roberts7531/JOX030/jox030.pdf

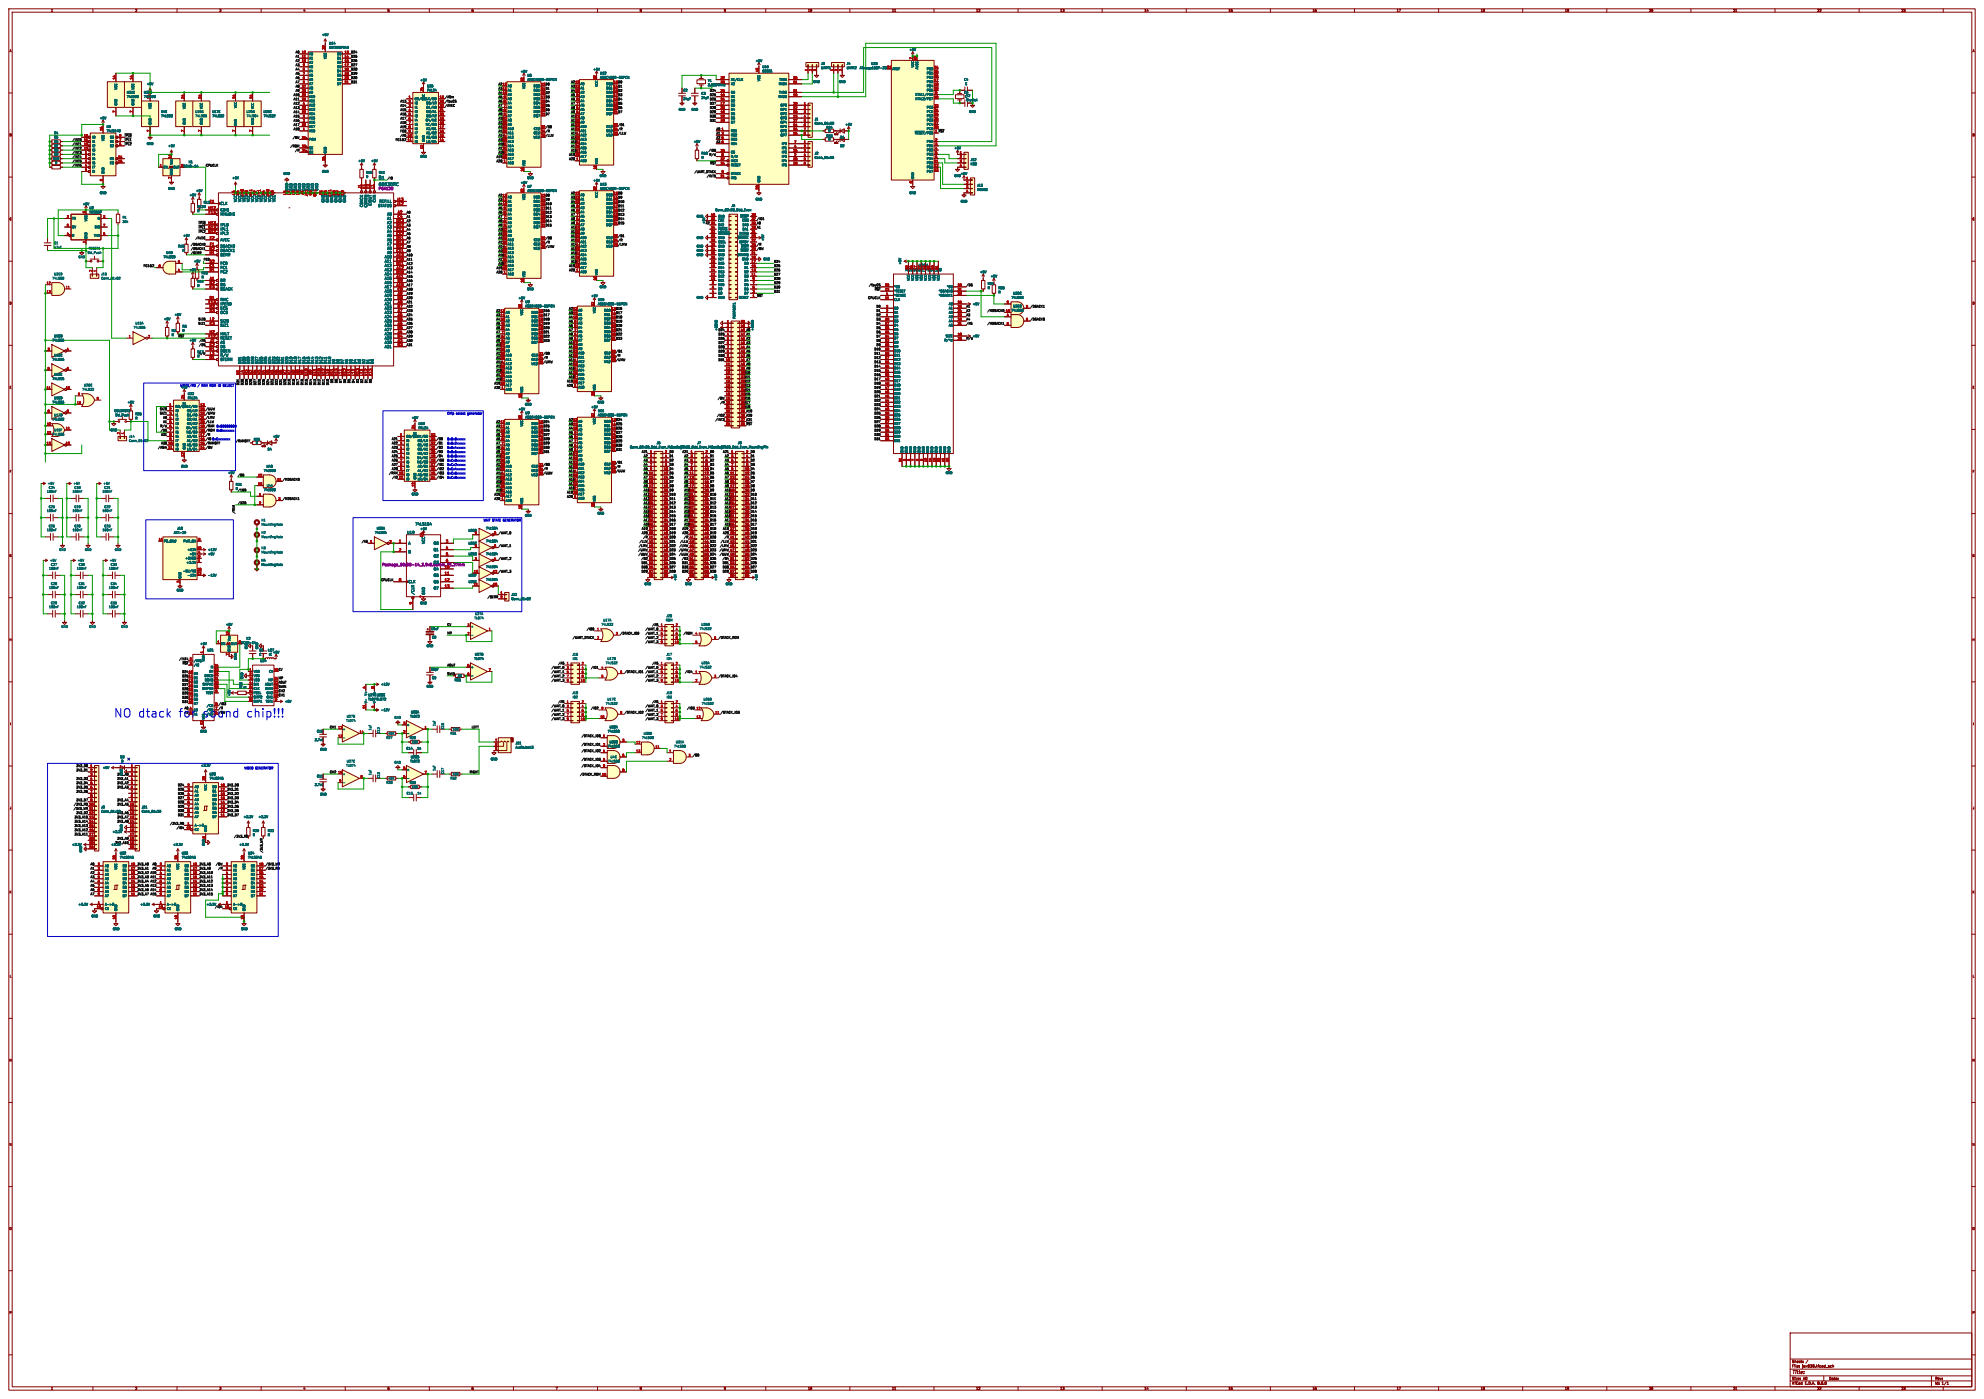
[picture p1: page 1]

0x0x2xxxxx NO dtack for sound chip!!!

Id: 1/1 Title: File: jox030.kicad_sch Sheet: /
