roberts7531/JOX030/ger/jox030-B_Cu.pdf

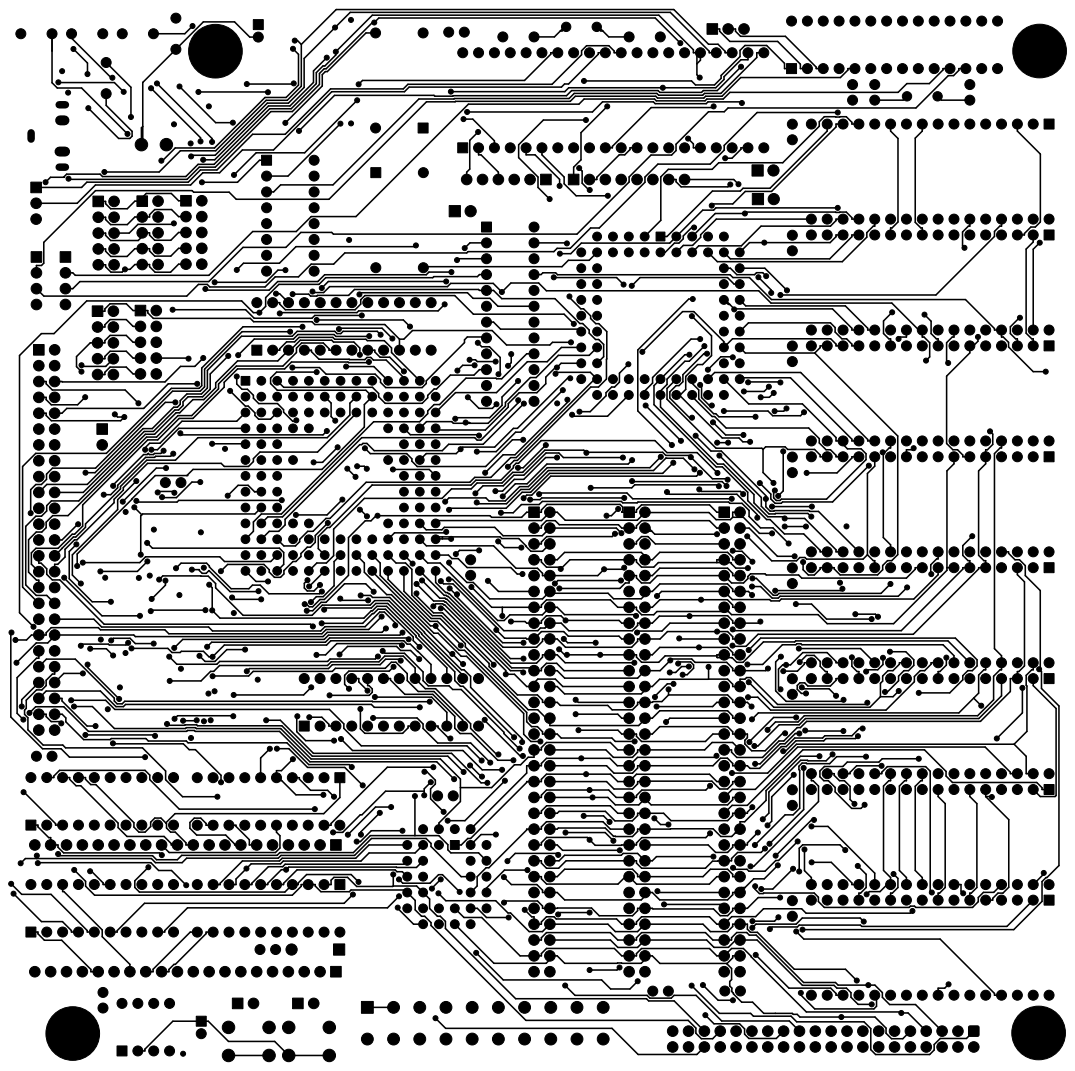
[picture p2: page 1]
