roberts7531/JOX030/ger/jox030-B_Mask.pdf

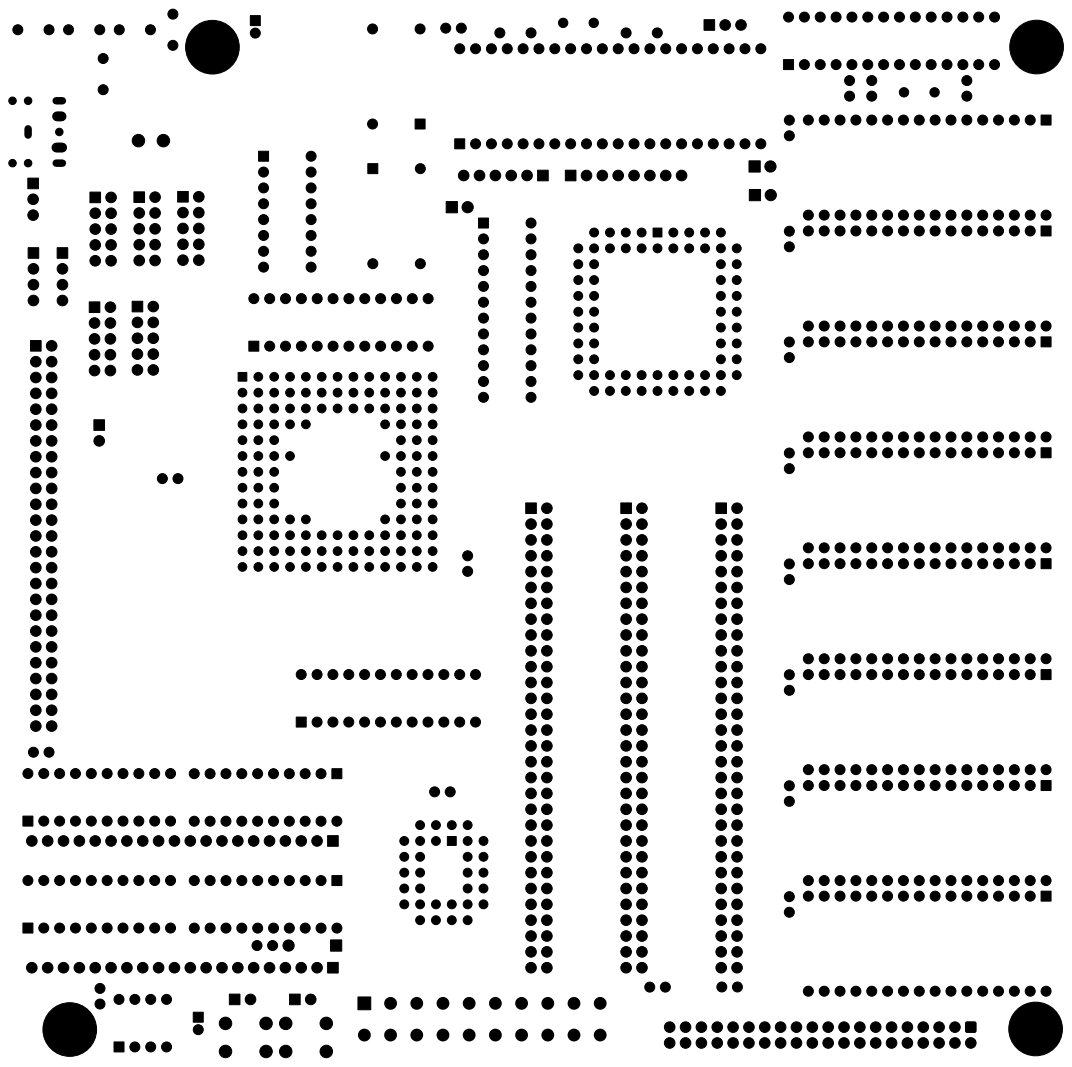
[picture p3: page 1]
