roberts7531/JOX030/ger/jox030-Edge_Cuts.pdf

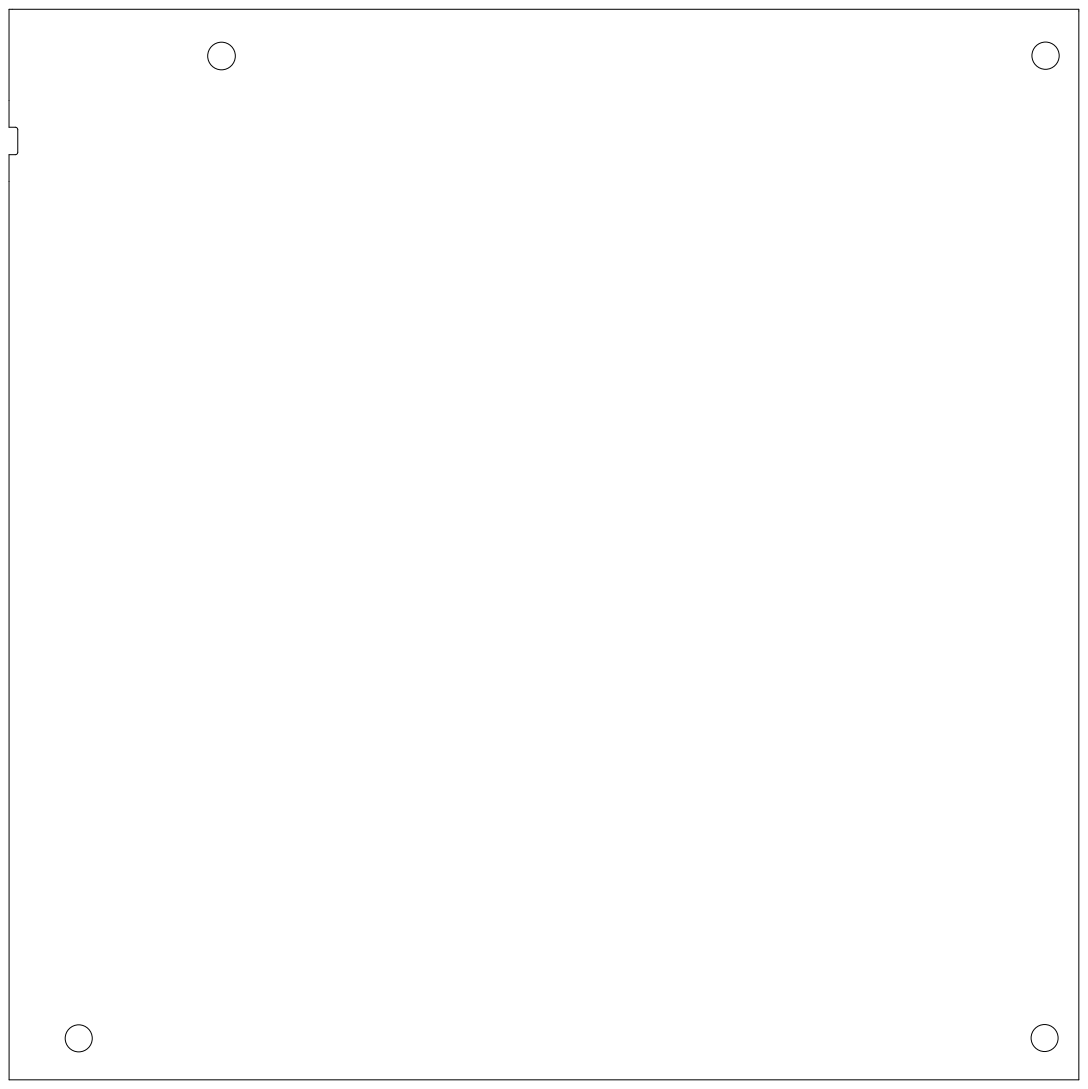
[picture p4: page 1]
