roberts7531/JOX030/ger/jox030-F_Cu.pdf

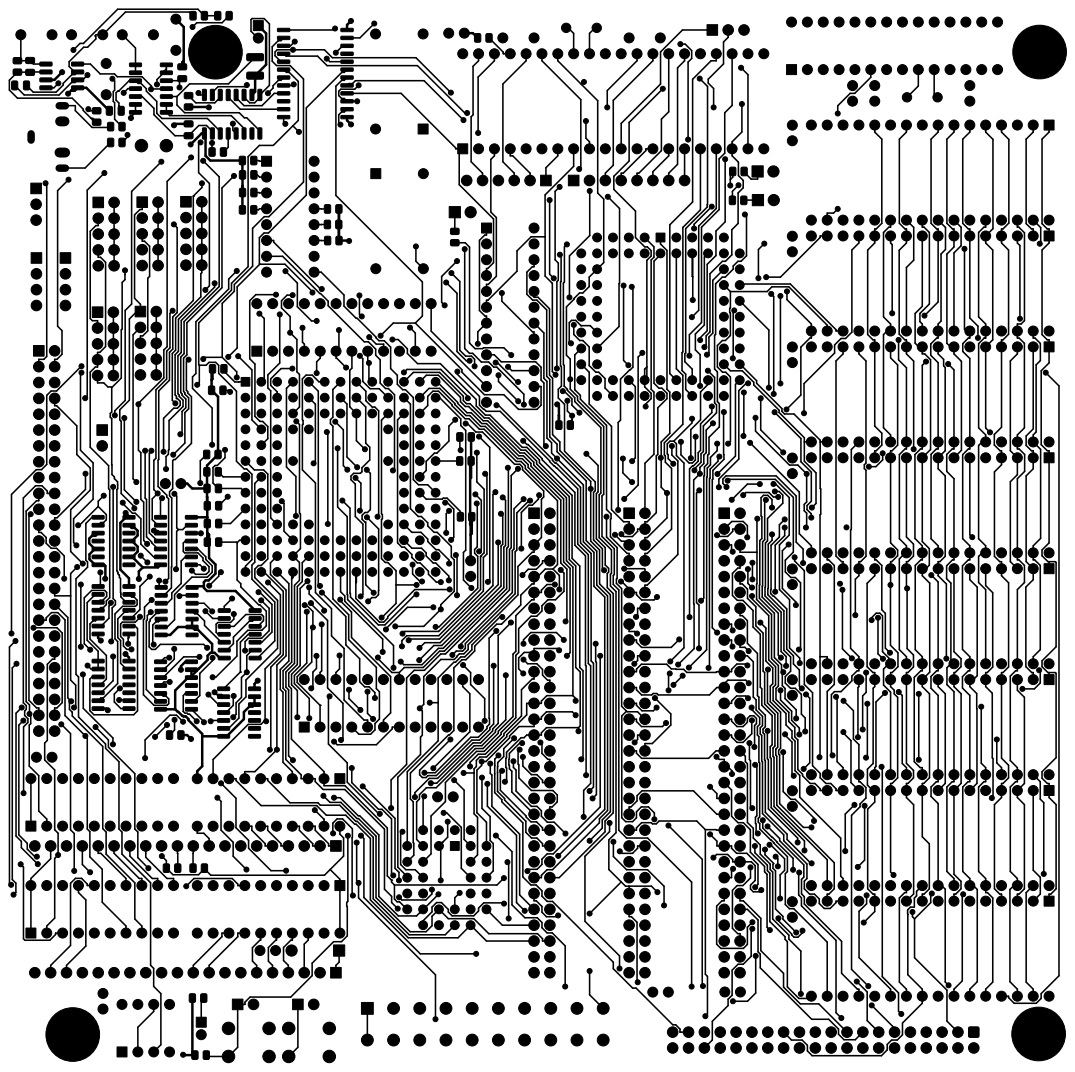
[picture p5: page 1]
