roberts7531/JOX030/ger/jox030-F_Mask.pdf

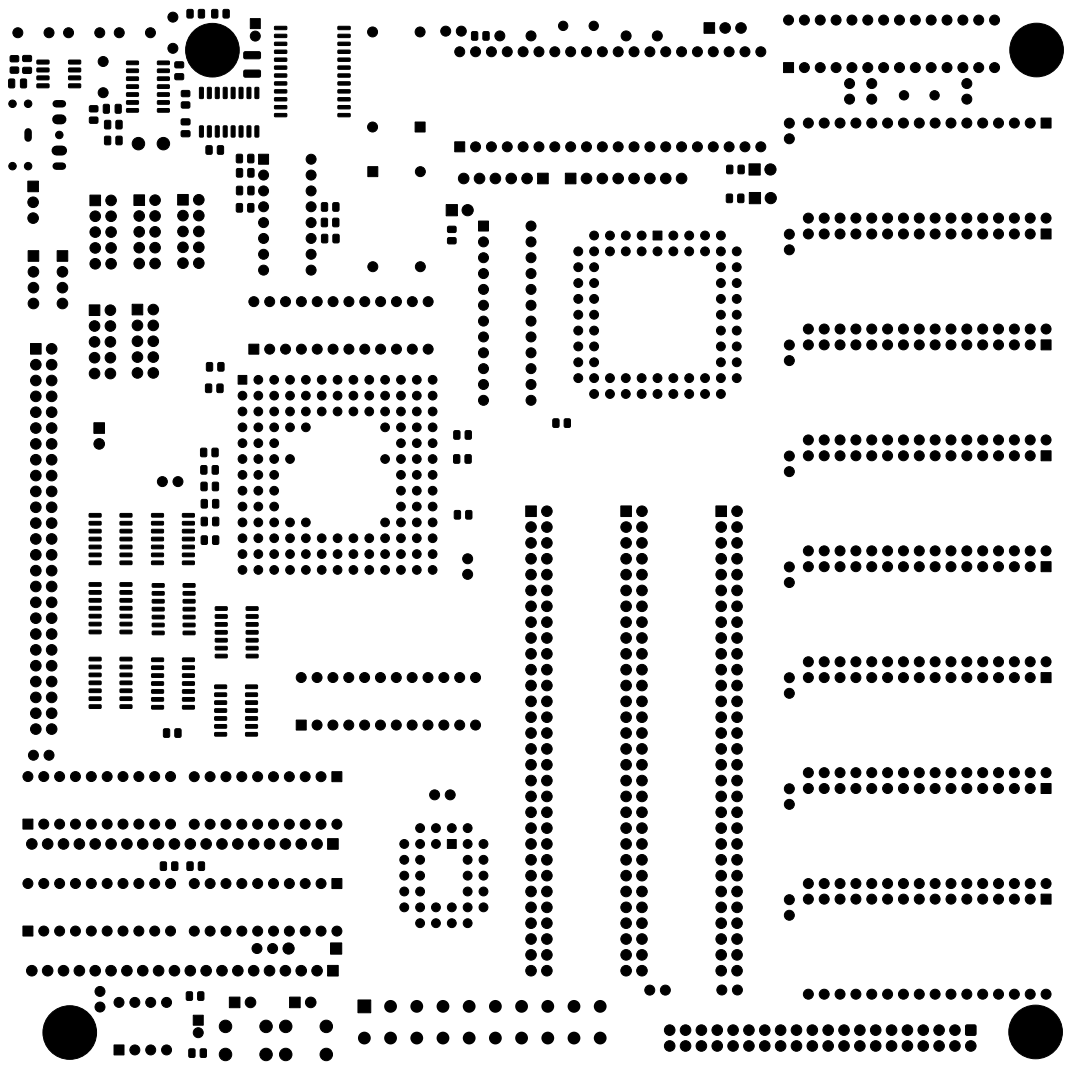
[picture p6: page 1]
