roberts7531/JOX030/ger/jox030-F_Paste.pdf

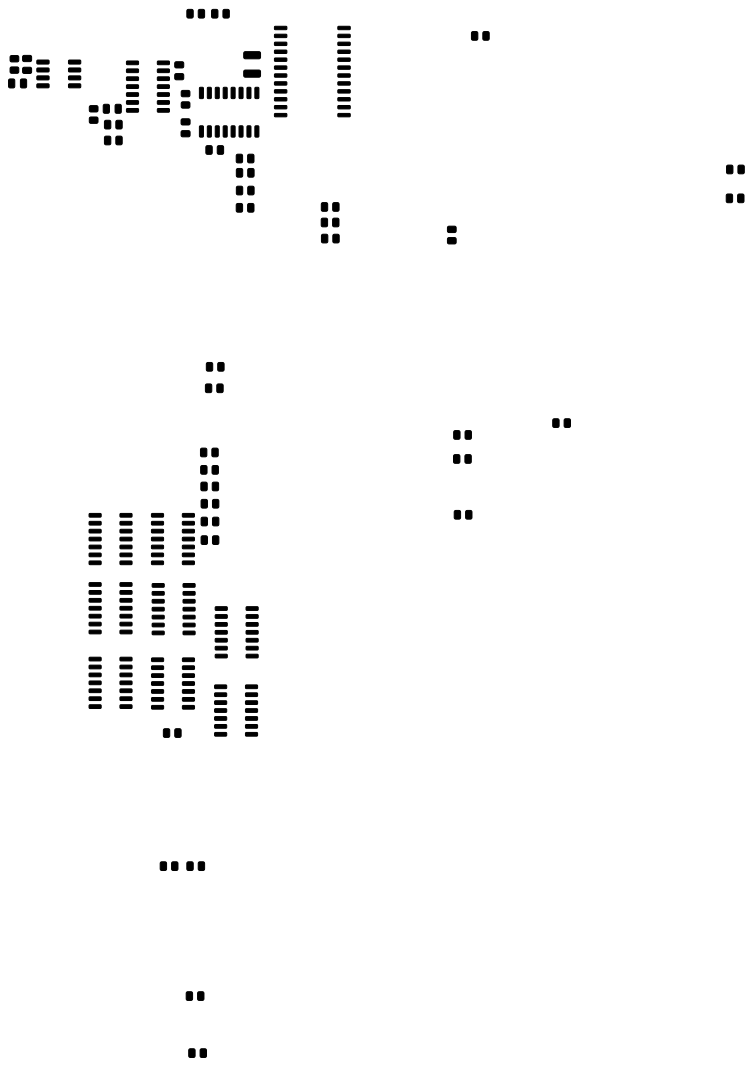
[picture p7: page 1]
