roberts7531/JOX030/ger/jox030-F_Silkscreen.pdf

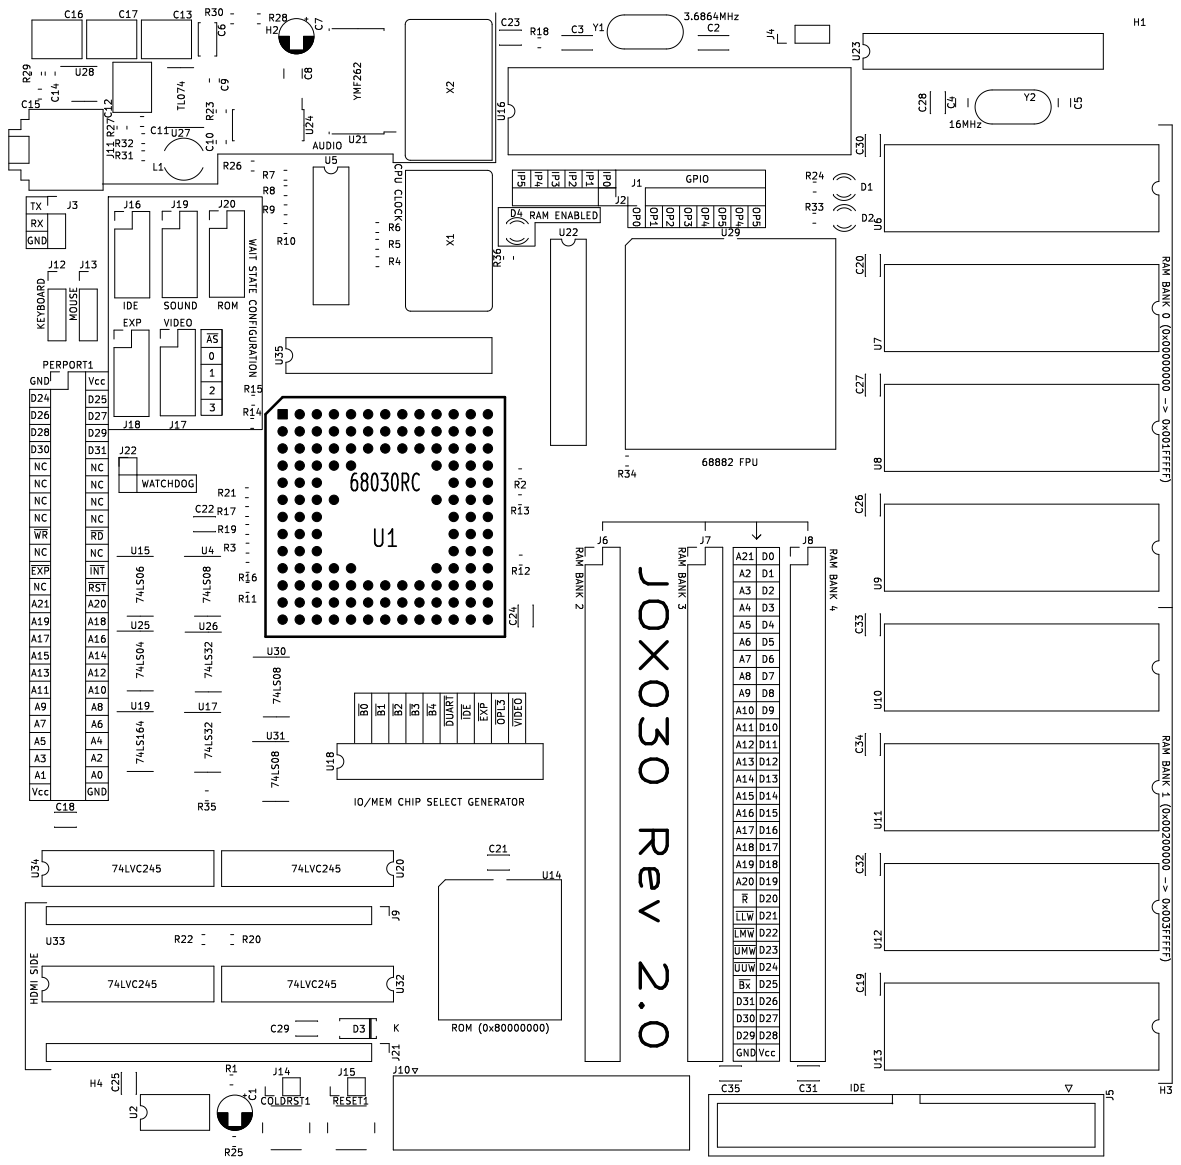
[picture p8: page 1]

IO/MEM CHIP SELECT GENERATOR
