roberts7531/JOX030/ger/jox030-In1_Cu.pdf

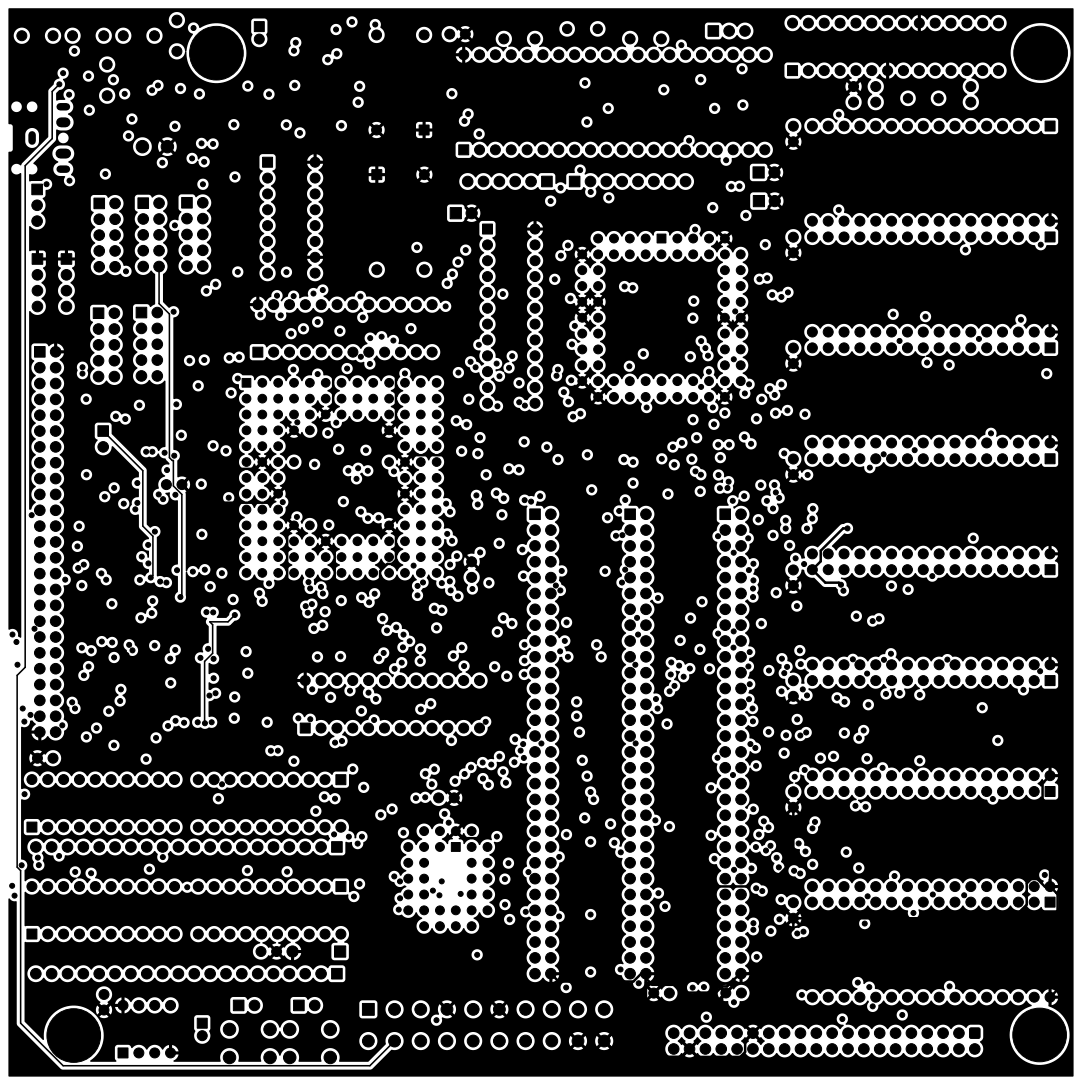
[picture p9: page 1]
