roberts7531/JOX030/ger/jox030-In2_Cu.pdf

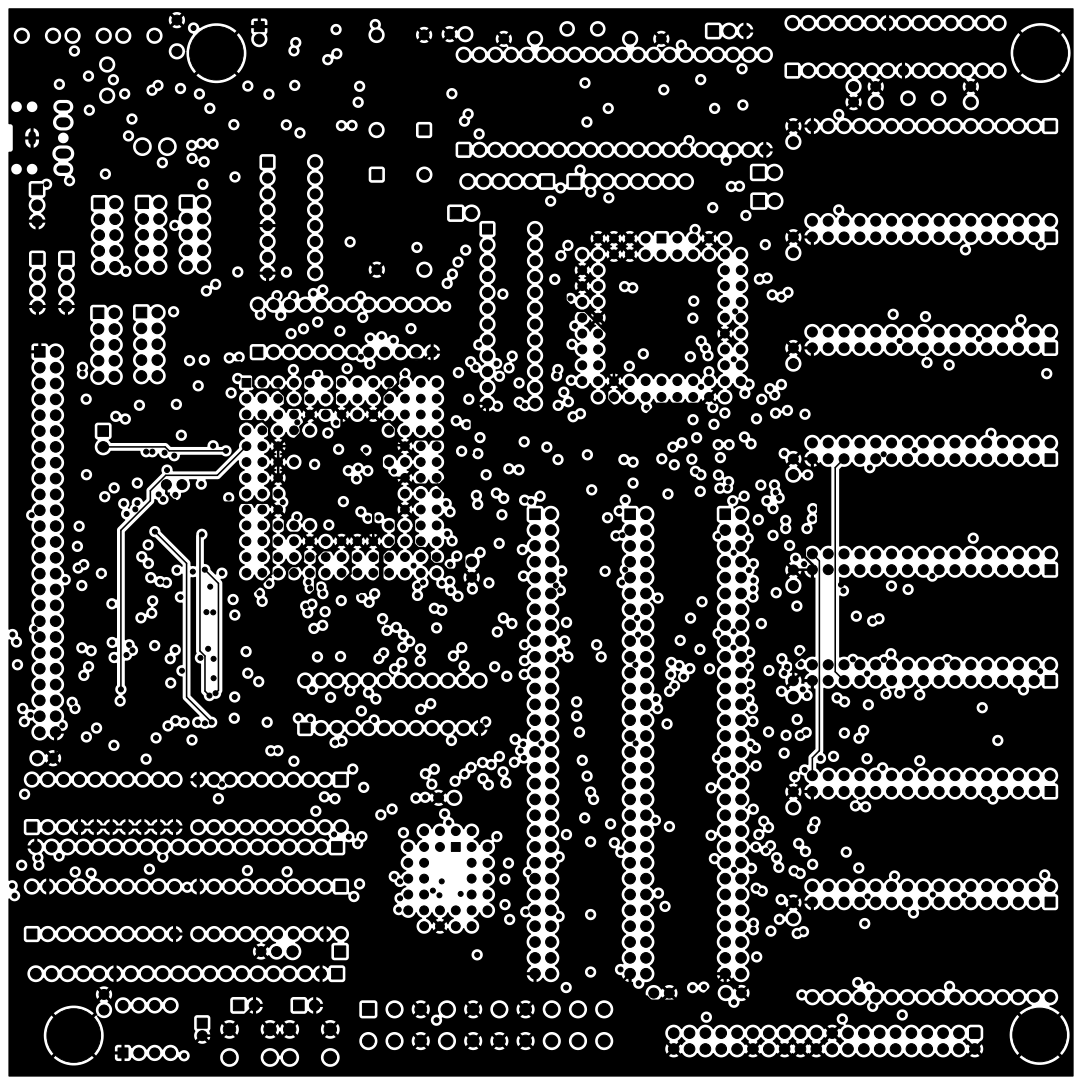
[picture p10: page 1]
