roberts7531/JOX030/(list of files, drawings)

Other design files:
freerouting.dsn
