roberts7531/JOX030/jox030.kicad_sch

## KiCad design jox030.kicad_sch (2024-05-07)

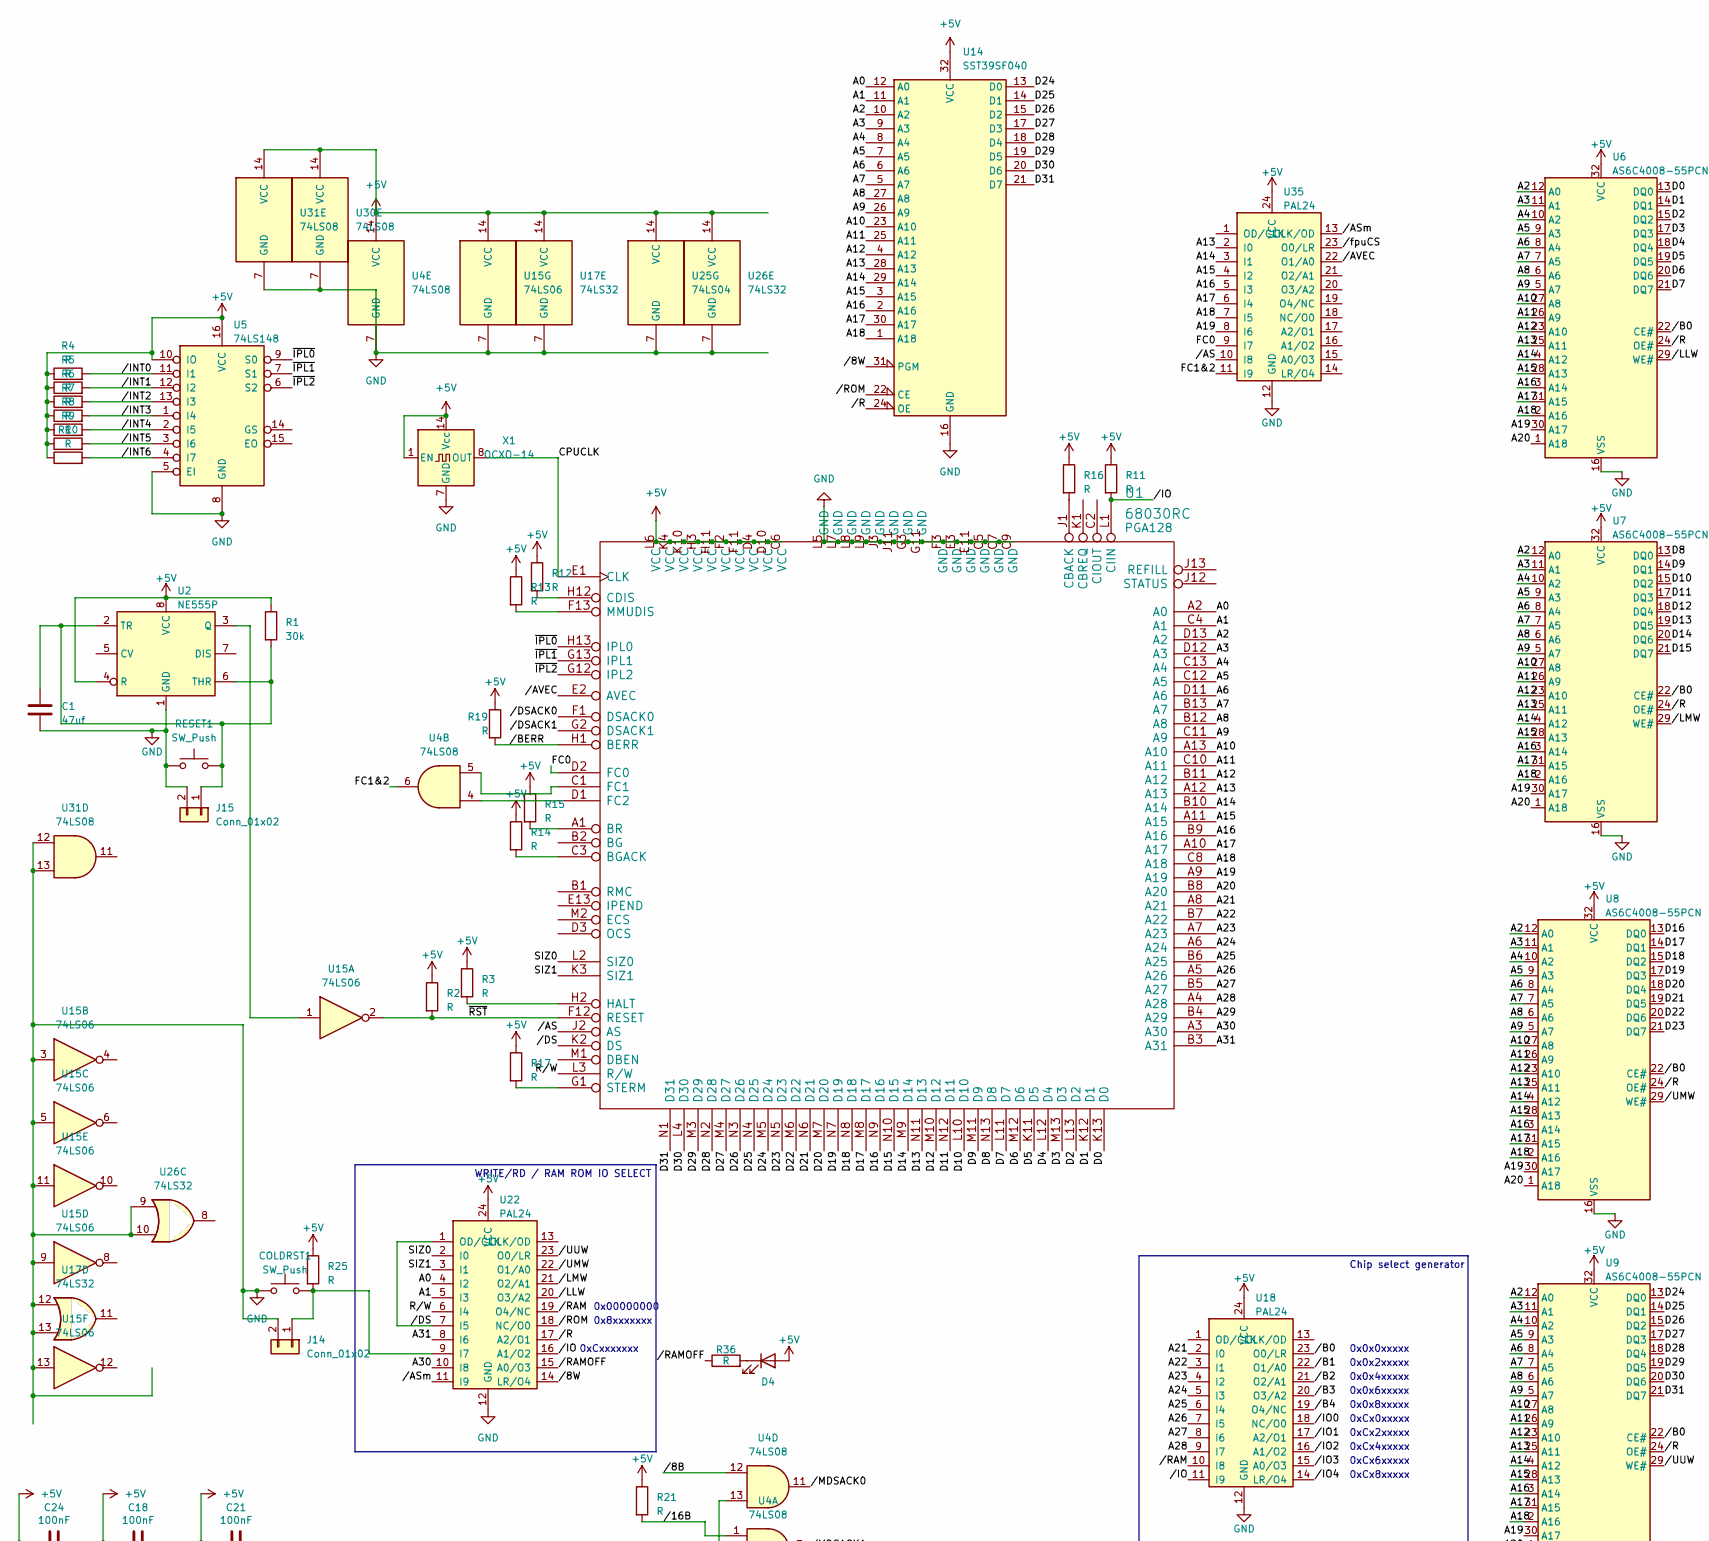
[picture p11: schematic jox030.kicad_sch, part in row 1, column 1]

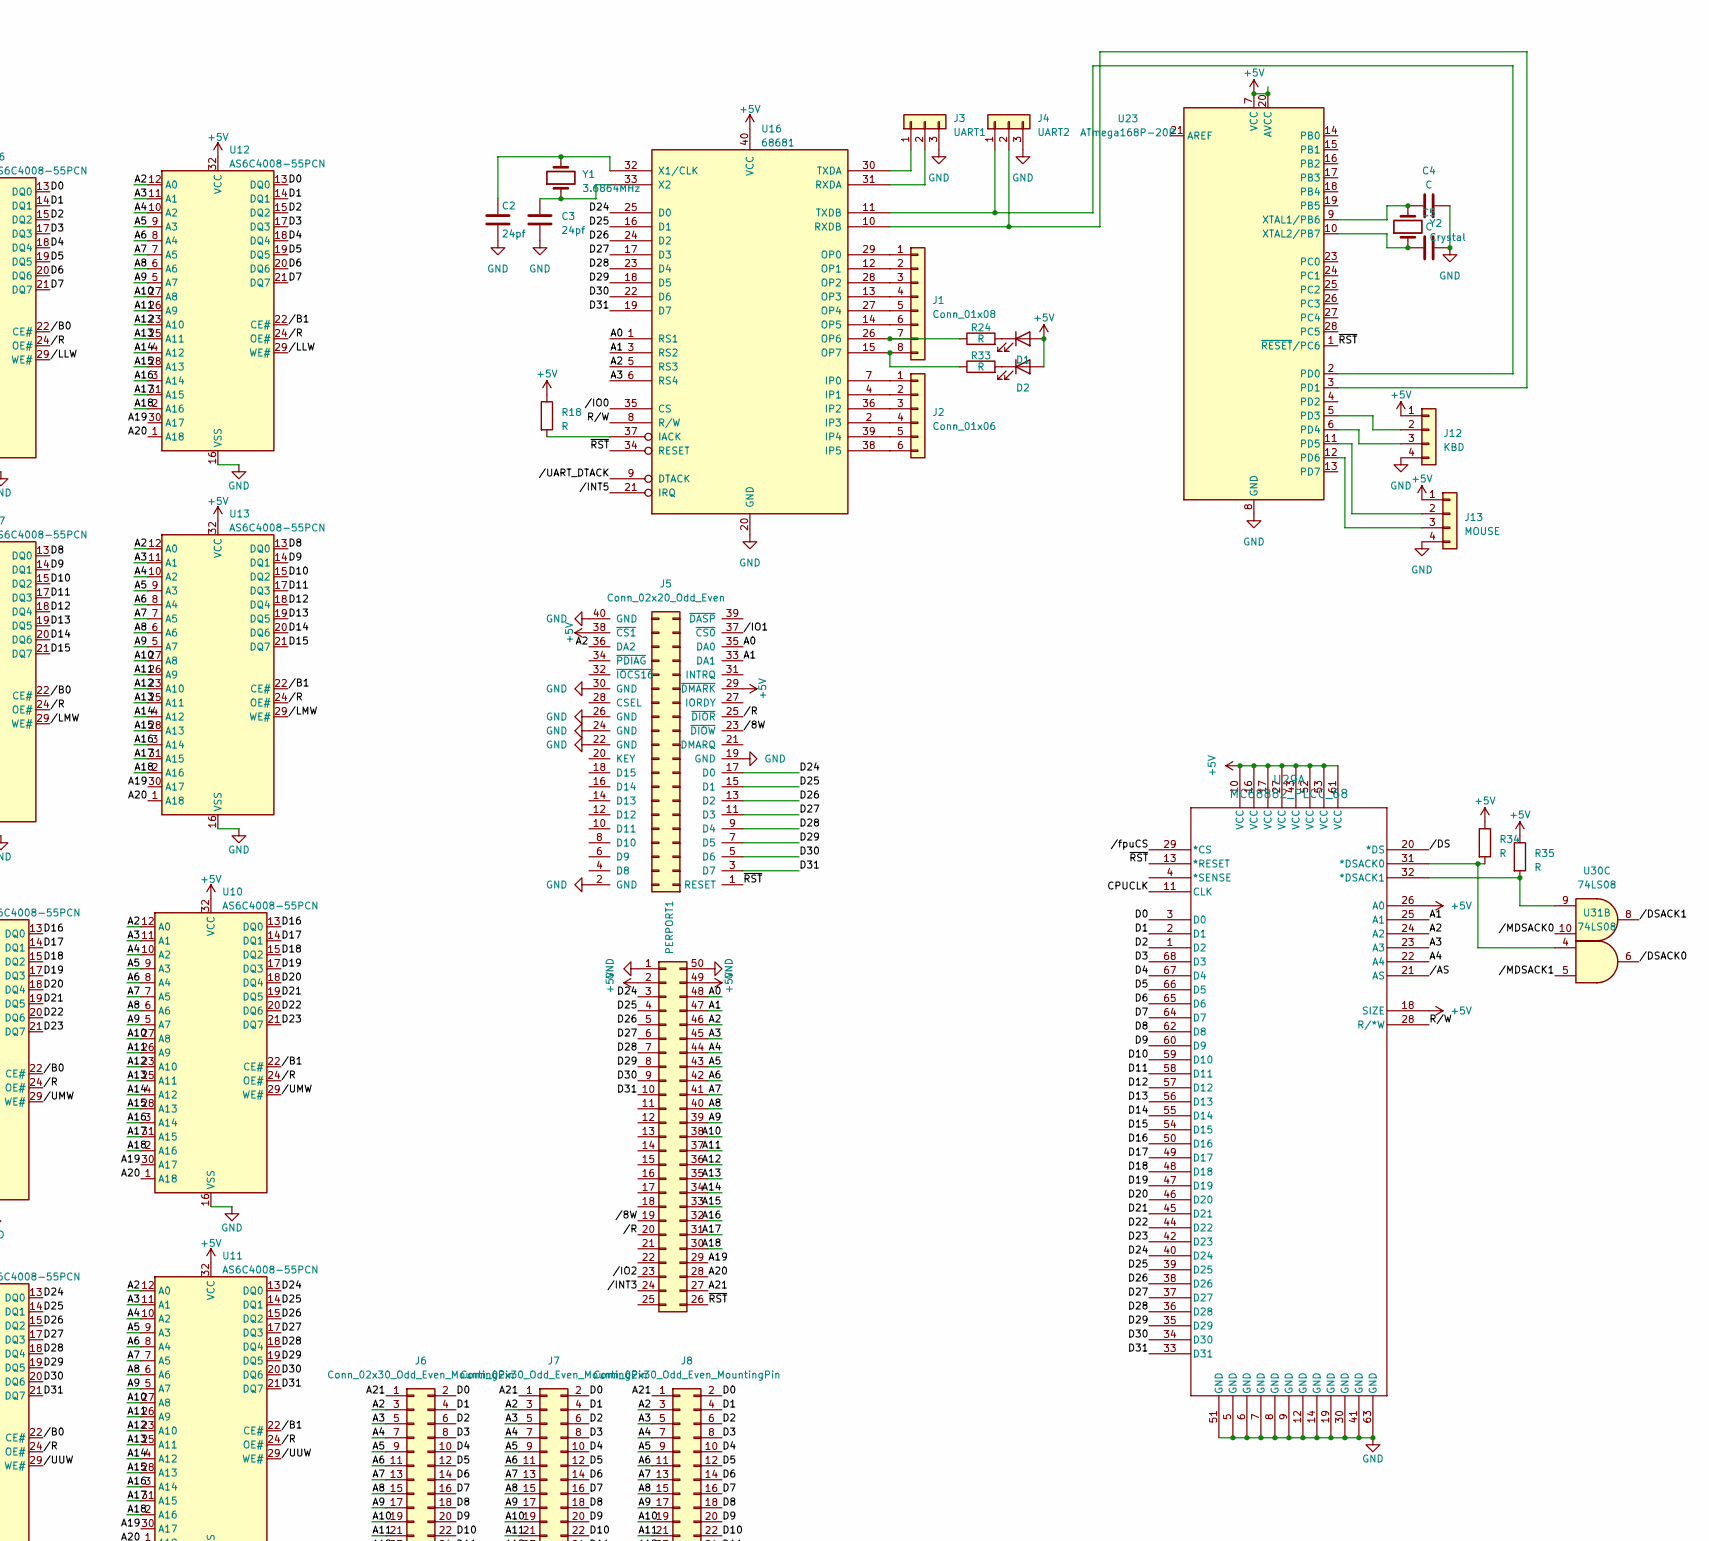
[picture p12: schematic jox030.kicad_sch, part in row 1, column 2]

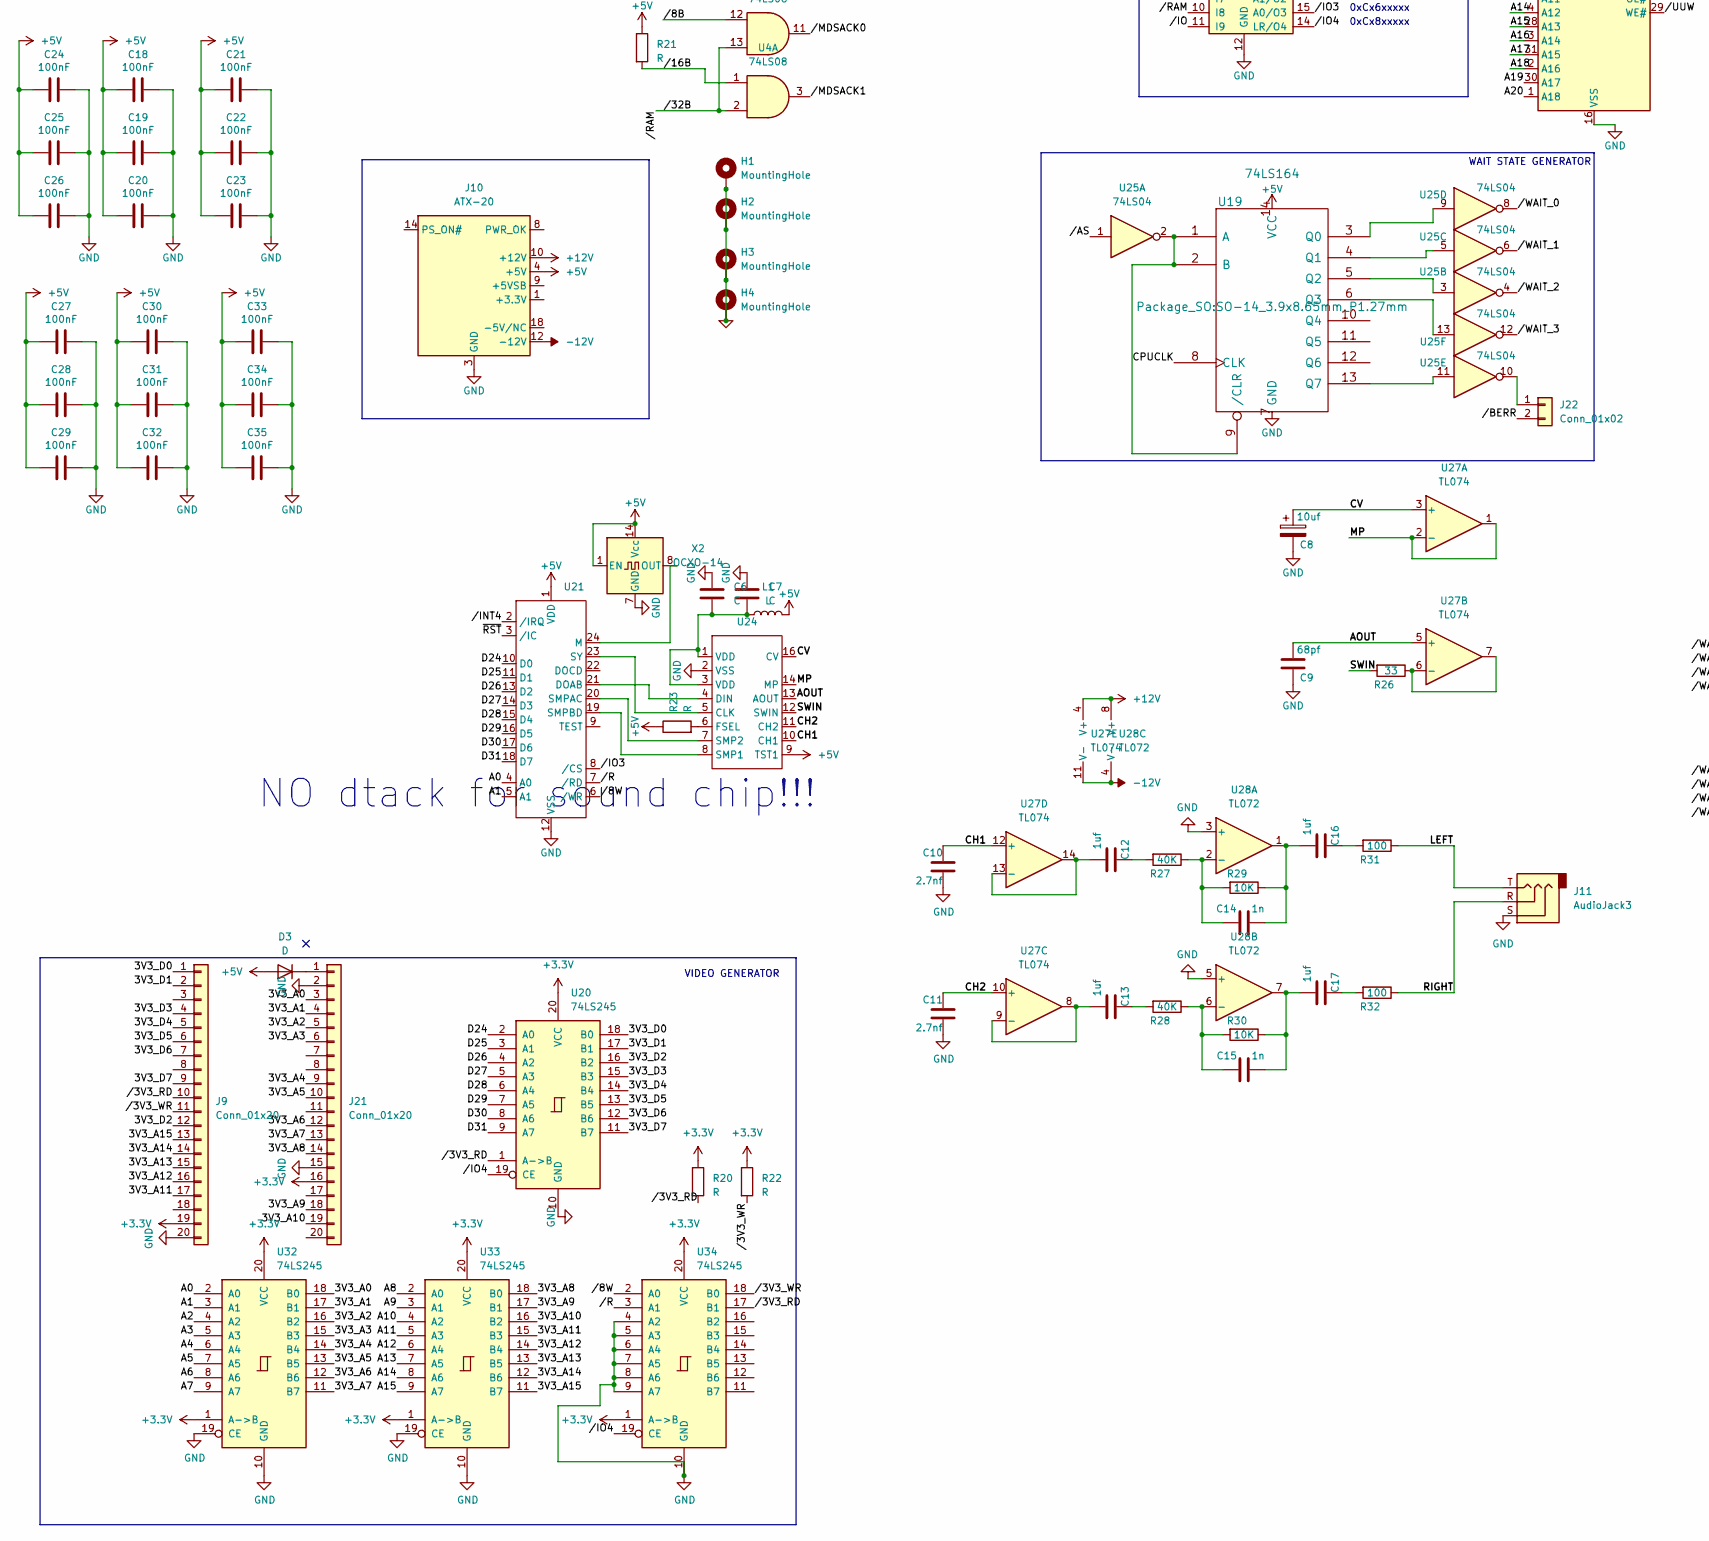
[picture p13: schematic jox030.kicad_sch, part in row 2, column 1]

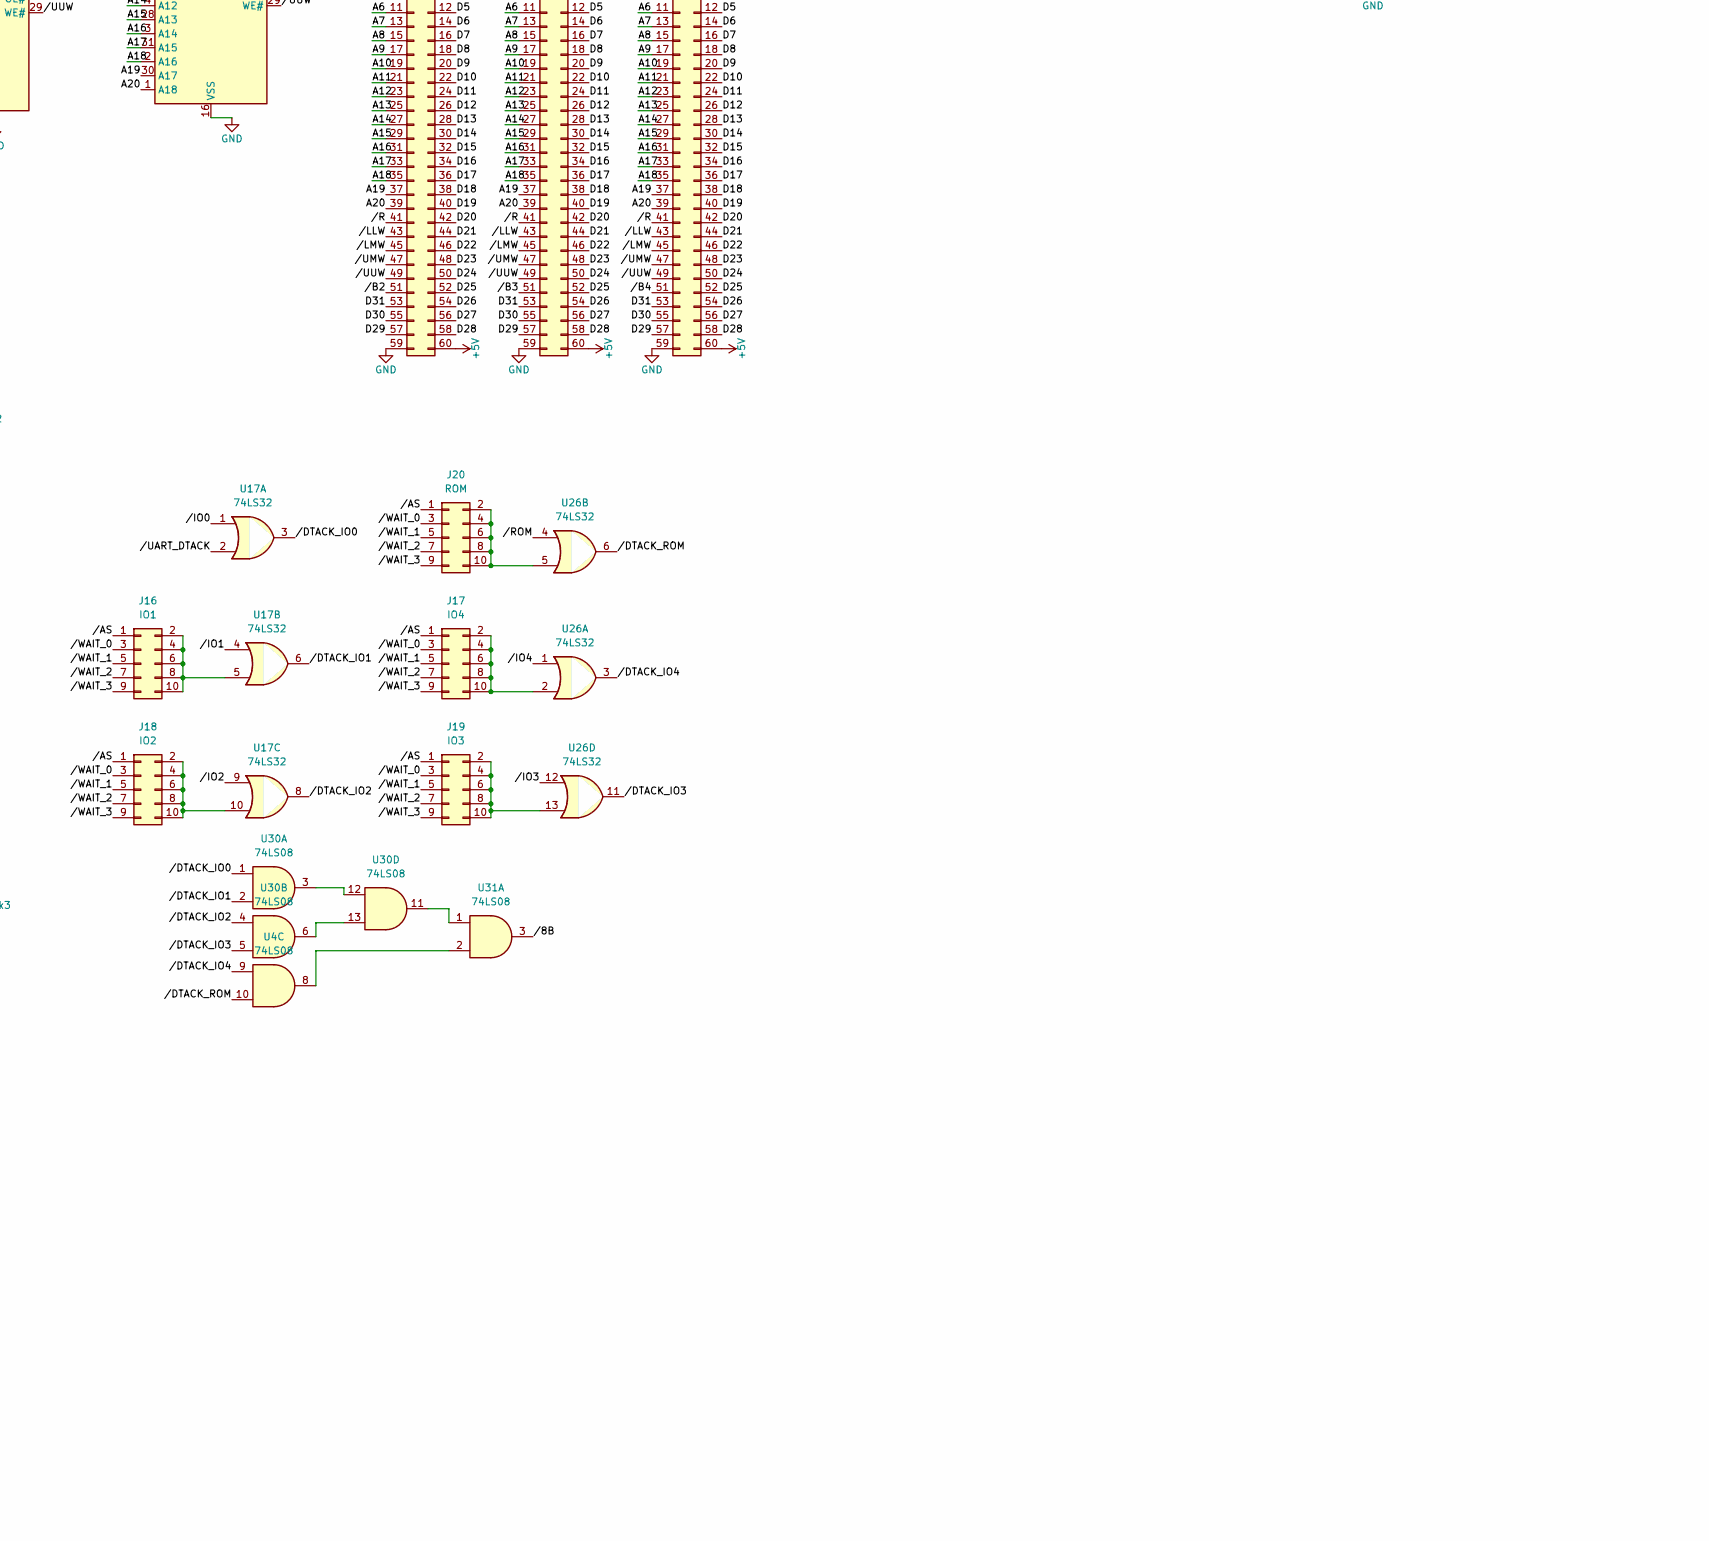
[picture p14: schematic jox030.kicad_sch, part in row 2, column 2]

Parts:
C1: 47uf; CP_Radial_D5.0mm_P2.00mm
C2, C3: 24pf; C_Disc_D4.3mm_W1.9mm_P5.00mm
C4, C5: C; C_Disc_D3.0mm_W1.6mm_P2.50mm
C6: C; C_Disc_D4.7mm_W2.5mm_P5.00mm
C7: C; CP_Radial_D5.0mm_P2.00mm
C8: 10uf; C_1210_3225Metric
C9: 68pf; C_0805_2012Metric
C10, C11: 2.7nf; C_0805_2012Metric
C12, C13, C16, C17: 1uf; C_Rect_L7.2mm_W5.5mm_P5.00mm_FKS2_FKP2_MKS2_MKP2
C14, C15: 1n; C_0805_2012Metric
C18, C19, C20, C21, C22, C23, C24, C25, C26, C27, C28, C29, C30, C31, C32, C33, C34, C35: 100nF; C_Disc_D3.0mm_W2.0mm_P2.50mm
COLDRST1: SW_Push; SW_PUSH_6mm
D1, D2, D4: FC2; LED_D3.0mm
D3: D; D_A-405_P7.62mm_Horizontal
H1, H2, H3, H4: MountingHole; MountingHole_4.3mm_M4_Pad_Via
J1: Conn_01x08; PinHeader_1x08_P2.54mm_Vertical
J2: Conn_01x06; PinHeader_1x06_P2.54mm_Vertical
J3: UART1; PinHeader_1x03_P2.54mm_Vertical
J4: UART2; PinHeader_1x03_P2.54mm_Vertical
J5: Conn_02x20_Odd_Even; IDC-Header_2x20_P2.54mm_Vertical
J6, J7, J8: Conn_02x30_Odd_Even_MountingPin; PinHeader_2x30_P2.54mm_Vertical
J9, J21: Conn_01x20; PinHeader_1x20_P2.54mm_Vertical
J10: ATX-20; MOLEX_39281203
J11: AudioJack3; Jack_3.5mm_CUI_SJ1-3525N_Horizontal
J12: KBD; PinHeader_1x04_P2.54mm_Vertical
J13: MOUSE; PinHeader_1x04_P2.54mm_Vertical
J14, J15, J22: Conn_01x02; PinHeader_1x02_P2.54mm_Vertical
J16: IO1; PinHeader_2x05_P2.54mm_Vertical
J17: IO4; PinHeader_2x05_P2.54mm_Vertical
J18: IO2; PinHeader_2x05_P2.54mm_Vertical
J19: IO3; PinHeader_2x05_P2.54mm_Vertical
J20: ROM; PinHeader_2x05_P2.54mm_Vertical
L1: L; L_Radial_D6.0mm_P4.00mm
PERPORT1: Conn_02x20_Counter_Clockwise; PinHeader_2x25_P2.54mm_Vertical
R1: 30k; R_0805_2012Metric
R2, R3, R4, R5, R6, R7, R8, R9, R10, R11, R12, R13, R14, R15, R16, R17, R18, R19, R20, R21, R22, R23, R24, R25, R33, R34, R35, R36: R; R_0805_2012Metric
R26: 33; R_0805_2012Metric
R27, R28: 40K; R_0805_2012Metric
R29, R30: 10K; R_0805_2012Metric
R31, R32: 100; R_0805_2012Metric
RESET1: SW_Push; SW_PUSH_6mm
U1: 68030RC; PGA128
U2: NE555P; DIP-8_W7.62mm
U4, U30, U31: 74LS08; SO-14_3.9x8.65mm_P1.27mm
U5: 74LS148; DIP-16_W7.62mm
U6, U7, U8, U9, U10, U11, U12, U13: AS6C4008-55PCN; DIP-32_W15.24mm
U14: SST39SF040; PLCC-32_THT-Socket
U15: 74LS06; SO-14_3.9x8.65mm_P1.27mm
U16: 68681; DIP-40_W15.24mm
U17, U26: 74LS32; SO-14_3.9x8.65mm_P1.27mm
U18, U22, U35: PAL24; DIP-24_W7.62mm
U19: 74LS164; SO-14_3.9x8.65mm_P1.27mm
U20, U32, U33, U34: 74LS245; DIP-20_W7.62mm
U21: SOP-24_7.5x15.4mm_P1.27mm
U23: ATmega168P-20P; DIP-28_W7.62mm
U24: SOP-16_4.4x10.4mm_P1.27mm
U25: 74LS04; SO-14_3.9x8.65mm_P1.27mm
U27: TL074; SO-14_3.9x8.65mm_P1.27mm
U28: TL072; SOP-8_3.76x4.96mm_P1.27mm
U29: MC68882_PLCC_68; PLCC-68_THT-Socket
X1, X2: OCXO-14; Oscillator_DIP-14
Y1: 3.6864MHz; Crystal_HC18-U_Vertical
Y2: Crystal; Crystal_HC18-U_Vertical

Connections:
3V3_A0: J21.3, U32.18 (B0)
3V3_A1: J21.4, U32.17 (B1)
3V3_A2: J21.5, U32.16 (B2)
3V3_A3: J21.6, U32.15 (B3)
3V3_A4: J21.9, U32.14 (B4)
3V3_A5: J21.10, U32.13 (B5)
3V3_A6: J21.12, U32.12 (B6)
3V3_A7: J21.13, U32.11 (B7)
3V3_A8: J21.14, U33.18 (B0)
3V3_A9: J21.18, U33.17 (B1)
3V3_A10: J21.19, U33.16 (B2)
3V3_A11: J9.17, U33.15 (B3)
3V3_A12: J9.16, U33.14 (B4)
3V3_A13: J9.15, U33.13 (B5)
3V3_A14: J9.14, U33.12 (B6)
3V3_A15: J9.13, U33.11 (B7)
3V3_D0: J9.1, U20.18 (B0)
3V3_D1: J9.2, U20.17 (B1)
3V3_D2: J9.12, U20.16 (B2)
3V3_D3: J9.4, U20.15 (B3)
3V3_D4: J9.5, U20.14 (B4)
3V3_D5: J9.6, U20.13 (B5)
3V3_D6: J9.7, U20.12 (B6)
3V3_D7: J9.9, U20.11 (B7)
+3.3V: J9.19, J21.16, R20.1, R22.1, U20.20 (VCC), U32.1 (A->B), U32.20 (VCC), U33.1 (A->B), U33.20 (VCC), U34.1 (A->B), U34.20 (VCC)
+5V: C18.2, C19.2, C20.2, C21.2, C22.2, C23.2, C24.2, C25.2, C26.2, C27.2, C28.2, C29.2, C30.2, C31.2, C32.2, C33.2, C34.2, C35.2, D1.2 (A), D2.2 (A), D3.2 (A), D4.2 (A), J5.29 (~DMARK), J5.38 (~CS1), J6.60, J7.60, J8.60, J10.4 (+5V), J10.6 (+5V), J10.19 (+5V), J10.20 (+5V), J12.1, J13.1, L1.2, PERPORT1.2, PERPORT1.49, R1.1, R2.1, R3.1, R4.1, R5.1, R6.1, R7.1, R8.1, R9.1, R10.1, R11.1, R12.1, R13.1, R14.1, R15.1, R16.1, R17.1, R18.1, R19.1, R21.1, R23.1, R25.1, R34.1, R35.1, U1.C6 (VCC), U1.D4 (VCC), U1.D10 (VCC), U1.F2 (VCC), U1.F11 (VCC), U1.H3 (VCC), U1.H11 (VCC), U1.K4 (VCC), U1.K10 (VCC), U1.L6 (VCC), U2.4 (R), U2.8 (VCC), U4.14 (VCC), U5.10 (IO), U5.16 (VCC), U6.32 (VCC), U7.32 (VCC), U8.32 (VCC), U9.32 (VCC), U10.32 (VCC), U11.32 (VCC), U12.32 (VCC), U13.32 (VCC), U14.32 (VCC), U15.14 (VCC), U16.40 (VCC), U17.14 (VCC), U18.24 (VCC), U19.14 (VCC), U21.1 (VDD), U22.24 (VCC), U23.7 (VCC), U23.20 (AVCC), U24.9 (TST1), U25.14 (VCC), U26.14 (VCC), U29.10 (VCC), U29.16 (VCC), U29.17 (VCC), U29.18 (SIZE), U29.26 (A0), U29.27 (VCC), U29.43 (VCC), U29.52 (VCC), U29.53 (VCC), U29.61 (VCC), U30.14 (VCC), U31.14 (VCC), U35.24 (VCC), X1.1 (EN), X1.14 (Vcc), X2.1 (EN), X2.14 (Vcc)
+12V: J10.10 (+12V), U27.4 (V+), U28.8 (V+)
-12V: J10.12 (-12V), U27.11 (V-), U28.4 (V-)
A0: J5.35 (DA0), PERPORT1.48, U1.A2 (A0), U14.12 (A0), U16.1 (RS1), U21.4 (A0), U22.4 (I2), U32.2 (A0)
A1: J5.33 (DA1), PERPORT1.47, U1.C4 (A1), U14.11 (A1), U16.3 (RS2), U21.5 (A1), U22.5 (I3), U29.25 (A1), U32.3 (A1)
A2: J5.36 (DA2), J6.3, J7.3, J8.3, PERPORT1.46, U1.D13 (A2), U6.12 (A0), U7.12 (A0), U8.12 (A0), U9.12 (A0), U10.12 (A0), U11.12 (A0), U12.12 (A0), U13.12 (A0), U14.10 (A2), U16.5 (RS3), U29.24 (A2), U32.4 (A2)
A3: J6.5, J7.5, J8.5, PERPORT1.45, U1.D12 (A3), U6.11 (A1), U7.11 (A1), U8.11 (A1), U9.11 (A1), U10.11 (A1), U11.11 (A1), U12.11 (A1), U13.11 (A1), U14.9 (A3), U16.6 (RS4), U29.23 (A3), U32.5 (A3)
A4: J6.7, J7.7, J8.7, PERPORT1.44, U1.C13 (A4), U6.10 (A2), U7.10 (A2), U8.10 (A2), U9.10 (A2), U10.10 (A2), U11.10 (A2), U12.10 (A2), U13.10 (A2), U14.8 (A4), U29.22 (A4), U32.6 (A4)
A5: J6.9, J7.9, J8.9, PERPORT1.43, U1.C12 (A5), U6.9 (A3), U7.9 (A3), U8.9 (A3), U9.9 (A3), U10.9 (A3), U11.9 (A3), U12.9 (A3), U13.9 (A3), U14.7 (A5), U32.7 (A5)
A6: J6.11, J7.11, J8.11, PERPORT1.42, U1.D11 (A6), U6.8 (A4), U7.8 (A4), U8.8 (A4), U9.8 (A4), U10.8 (A4), U11.8 (A4), U12.8 (A4), U13.8 (A4), U14.6 (A6), U32.8 (A6)
A7: J6.13, J7.13, J8.13, PERPORT1.41, U1.B13 (A7), U6.7 (A5), U7.7 (A5), U8.7 (A5), U9.7 (A5), U10.7 (A5), U11.7 (A5), U12.7 (A5), U13.7 (A5), U14.5 (A7), U32.9 (A7)
A8: J6.15, J7.15, J8.15, PERPORT1.40, U1.B12 (A8), U6.6 (A6), U7.6 (A6), U8.6 (A6), U9.6 (A6), U10.6 (A6), U11.6 (A6), U12.6 (A6), U13.6 (A6), U14.27 (A8), U33.2 (A0)
A9: J6.17, J7.17, J8.17, PERPORT1.39, U1.C11 (A9), U6.5 (A7), U7.5 (A7), U8.5 (A7), U9.5 (A7), U10.5 (A7), U11.5 (A7), U12.5 (A7), U13.5 (A7), U14.26 (A9), U33.3 (A1)
A10: J6.19, J7.19, J8.19, PERPORT1.38, U1.A13 (A10), U6.27 (A8), U7.27 (A8), U8.27 (A8), U9.27 (A8), U10.27 (A8), U11.27 (A8), U12.27 (A8), U13.27 (A8), U14.23 (A10), U33.4 (A2)
A11: J6.21, J7.21, J8.21, PERPORT1.37, U1.C10 (A11), U6.26 (A9), U7.26 (A9), U8.26 (A9), U9.26 (A9), U10.26 (A9), U11.26 (A9), U12.26 (A9), U13.26 (A9), U14.25 (A11), U33.5 (A3)
A12: J6.23, J7.23, J8.23, PERPORT1.36, U1.B11 (A12), U6.23 (A10), U7.23 (A10), U8.23 (A10), U9.23 (A10), U10.23 (A10), U11.23 (A10), U12.23 (A10), U13.23 (A10), U14.4 (A12), U33.6 (A4)
A13: J6.25, J7.25, J8.25, PERPORT1.35, U1.A12 (A13), U6.25 (A11), U7.25 (A11), U8.25 (A11), U9.25 (A11), U10.25 (A11), U11.25 (A11), U12.25 (A11), U13.25 (A11), U14.28 (A13), U33.7 (A5), U35.2 (I0)
A14: J6.27, J7.27, J8.27, PERPORT1.34, U1.B10 (A14), U6.4 (A12), U7.4 (A12), U8.4 (A12), U9.4 (A12), U10.4 (A12), U11.4 (A12), U12.4 (A12), U13.4 (A12), U14.29 (A14), U33.8 (A6), U35.3 (I1)
A15: J6.29, J7.29, J8.29, PERPORT1.33, U1.A11 (A15), U6.28 (A13), U7.28 (A13), U8.28 (A13), U9.28 (A13), U10.28 (A13), U11.28 (A13), U12.28 (A13), U13.28 (A13), U14.3 (A15), U33.9 (A7), U35.4 (I2)
A16: J6.31, J7.31, J8.31, PERPORT1.32, U1.B9 (A16), U6.3 (A14), U7.3 (A14), U8.3 (A14), U9.3 (A14), U10.3 (A14), U11.3 (A14), U12.3 (A14), U13.3 (A14), U14.2 (A16), U35.5 (I3)
A17: J6.33, J7.33, J8.33, PERPORT1.31, U1.A10 (A17), U6.31 (A15), U7.31 (A15), U8.31 (A15), U9.31 (A15), U10.31 (A15), U11.31 (A15), U12.31 (A15), U13.31 (A15), U14.30 (A17), U35.6 (I4)
A18: J6.35, J7.35, J8.35, PERPORT1.30, U1.C8 (A18), U6.2 (A16), U7.2 (A16), U8.2 (A16), U9.2 (A16), U10.2 (A16), U11.2 (A16), U12.2 (A16), U13.2 (A16), U14.1 (A18), U35.7 (I5)
A19: J6.37, J7.37, J8.37, PERPORT1.29, U1.A9 (A19), U6.30 (A17), U7.30 (A17), U8.30 (A17), U9.30 (A17), U10.30 (A17), U11.30 (A17), U12.30 (A17), U13.30 (A17), U35.8 (I6)
A20: J6.39, J7.39, J8.39, PERPORT1.28, U1.B8 (A20), U6.1 (A18), U7.1 (A18), U8.1 (A18), U9.1 (A18), U10.1 (A18), U11.1 (A18), U12.1 (A18), U13.1 (A18)
A21: J6.1, J7.1, J8.1, PERPORT1.27, U1.A8 (A21), U18.2 (I0)
A22: U1.B7 (A22), U18.3 (I1)
A23: U1.A7 (A23), U18.4 (I2)
A24: U1.A6 (A24), U18.5 (I3)
A25: U1.B6 (A25), U18.6 (I4)
A26: U1.A5 (A26), U18.7 (I5)
A27: U1.B5 (A27), U18.8 (I6)
A28: U1.A4 (A28), U18.9 (I7)
A29: U1.B4 (A29)
A30: U1.A3 (A30), U22.10 (I8)
A31: U1.B3 (A31), U22.8 (I6)
AOUT: C9.2, U24.13 (AOUT), U27.5 (+)
CH1: C10.1, U24.10 (CH1), U27.12 (+)
CH2: C11.1, U24.11 (CH2), U27.10 (+)
CPUCLK: U1.E1 (CLK), U19.8 (CLK), U29.11 (CLK), X1.8 (OUT)
CV: C8.1, U24.16 (CV), U27.3 (+)
D0: J6.2, J7.2, J8.2, U1.K13 (D0), U6.13 (DQ0), U12.13 (DQ0), U29.3 (D0)
D1: J6.4, J7.4, J8.4, U1.K12 (D1), U6.14 (DQ1), U12.14 (DQ1), U29.2 (D1)
D2: J6.6, J7.6, J8.6, U1.L13 (D2), U6.15 (DQ2), U12.15 (DQ2), U29.1 (D2)
D3: J6.8, J7.8, J8.8, U1.M13 (D3), U6.17 (DQ3), U12.17 (DQ3), U29.68 (D3)
D4: J6.10, J7.10, J8.10, U1.L12 (D4), U6.18 (DQ4), U12.18 (DQ4), U29.67 (D4)
D5: J6.12, J7.12, J8.12, U1.K11 (D5), U6.19 (DQ5), U12.19 (DQ5), U29.66 (D5)
D6: J6.14, J7.14, J8.14, U1.M12 (D6), U6.20 (DQ6), U12.20 (DQ6), U29.65 (D6)
D7: J6.16, J7.16, J8.16, U1.L11 (D7), U6.21 (DQ7), U12.21 (DQ7), U29.64 (D7)
D8: J6.18, J7.18, J8.18, U1.N13 (D8), U7.13 (DQ0), U13.13 (DQ0), U29.62 (D8)
D9: J6.20, J7.20, J8.20, U1.M11 (D9), U7.14 (DQ1), U13.14 (DQ1), U29.60 (D9)
D10: J6.22, J7.22, J8.22, U1.L10 (D10), U7.15 (DQ2), U13.15 (DQ2), U29.59 (D10)
D11: J6.24, J7.24, J8.24, U1.N12 (D11), U7.17 (DQ3), U13.17 (DQ3), U29.58 (D11)
D12: J6.26, J7.26, J8.26, U1.M10 (D12), U7.18 (DQ4), U13.18 (DQ4), U29.57 (D12)
D13: J6.28, J7.28, J8.28, U1.N11 (D13), U7.19 (DQ5), U13.19 (DQ5), U29.56 (D13)
D14: J6.30, J7.30, J8.30, U1.M9 (D14), U7.20 (DQ6), U13.20 (DQ6), U29.55 (D14)
D15: J6.32, J7.32, J8.32, U1.N10 (D15), U7.21 (DQ7), U13.21 (DQ7), U29.54 (D15)
D16: J6.34, J7.34, J8.34, U1.N9 (D16), U8.13 (DQ0), U10.13 (DQ0), U29.50 (D16)
D17: J6.36, J7.36, J8.36, U1.M8 (D17), U8.14 (DQ1), U10.14 (DQ1), U29.49 (D17)
D18: J6.38, J7.38, J8.38, U1.N8 (D18), U8.15 (DQ2), U10.15 (DQ2), U29.48 (D18)
D19: J6.40, J7.40, J8.40, U1.N7 (D19), U8.17 (DQ3), U10.17 (DQ3), U29.47 (D19)
D20: J6.42, J7.42, J8.42, U1.M7 (D20), U8.18 (DQ4), U10.18 (DQ4), U29.46 (D20)
D21: J6.44, J7.44, J8.44, U1.N6 (D21), U8.19 (DQ5), U10.19 (DQ5), U29.45 (D21)
D22: J6.46, J7.46, J8.46, U1.M6 (D22), U8.20 (DQ6), U10.20 (DQ6), U29.44 (D22)
D23: J6.48, J7.48, J8.48, U1.N5 (D23), U8.21 (DQ7), U10.21 (DQ7), U29.42 (D23)
D24: J5.17 (D0), J6.50, J7.50, J8.50, PERPORT1.3, U1.M5 (D24), U9.13 (DQ0), U11.13 (DQ0), U14.13 (D0), U16.25 (D0), U20.2 (A0), U21.10 (D0), U29.40 (D24)
D25: J5.15 (D1), J6.52, J7.52, J8.52, PERPORT1.4, U1.N4 (D25), U9.14 (DQ1), U11.14 (DQ1), U14.14 (D1), U16.16 (D1), U20.3 (A1), U21.11 (D1), U29.39 (D25)
D26: J5.13 (D2), J6.54, J7.54, J8.54, PERPORT1.5, U1.N3 (D26), U9.15 (DQ2), U11.15 (DQ2), U14.15 (D2), U16.24 (D2), U20.4 (A2), U21.13 (D2), U29.38 (D26)
D27: J5.11 (D3), J6.56, J7.56, J8.56, PERPORT1.6, U1.M4 (D27), U9.17 (DQ3), U11.17 (DQ3), U14.17 (D3), U16.17 (D3), U20.5 (A3), U21.14 (D3), U29.37 (D27)
D28: J5.9 (D4), J6.58, J7.58, J8.58, PERPORT1.7, U1.N2 (D28), U9.18 (DQ4), U11.18 (DQ4), U14.18 (D4), U16.23 (D4), U20.6 (A4), U21.15 (D4), U29.36 (D28)
D29: J5.7 (D5), J6.57, J7.57, J8.57, PERPORT1.8, U1.M3 (D29), U9.19 (DQ5), U11.19 (DQ5), U14.19 (D5), U16.18 (D5), U20.7 (A5), U21.16 (D5), U29.35 (D29)
D30: J5.5 (D6), J6.55, J7.55, J8.55, PERPORT1.9, U1.L4 (D30), U9.20 (DQ6), U11.20 (DQ6), U14.20 (D6), U16.22 (D6), U20.8 (A6), U21.17 (D6), U29.34 (D30)
D31: J5.3 (D7), J6.53, J7.53, J8.53, PERPORT1.10, U1.N1 (D31), U9.21 (DQ7), U11.21 (DQ7), U14.21 (D7), U16.19 (D7), U20.9 (A7), U21.18 (D7), U29.33 (D31)
FC0: U1.D2 (FC0), U35.9 (I7)
FC1&2: U4.6, U35.11 (I9)
GND: C1.2, C2.2, C3.2, C4.2, C5.2, C6.1, C7.1, C8.2, C9.1, C10.2, C11.2, C18.1, C19.1, C20.1, C21.1, C22.1, C23.1, C24.1, C25.1, C26.1, C27.1, C28.1, C29.1, C30.1, C31.1, C32.1, C33.1, C34.1, C35.1, COLDRST1.1, H1.1, H2.1, H3.1, H4.1, J3.3, J4.3, J5.2 (GND), J5.19 (GND), J5.22 (GND), J5.24 (GND), J5.26 (GND), J5.30 (GND), J5.40 (GND), J6.59, J7.59, J8.59, J9.20, J10.3 (GND), J10.5 (GND), J10.7 (GND), J10.13 (GND), J10.15 (GND), J10.16 (GND), J10.17 (GND), J11.S, J12.4, J13.4, J14.2, J15.2, J21.2, J21.15, PERPORT1.1, PERPORT1.50, RESET1.1, U1.C5 (GND), U1.C7 (GND), U1.C9 (GND), U1.E3 (GND), U1.E11 (GND), U1.F3 (GND), U1.G3 (GND), U1.G11 (GND), U1.J3 (GND), U1.J11 (GND), U1.L5 (GND), U1.L7 (GND), U1.L8 (GND), U1.L9 (GND), U2.1 (GND), U4.7 (GND), U5.5 (EI), U5.8 (GND), U6.16 (VSS), U7.16 (VSS), U8.16 (VSS), U9.16 (VSS), U10.16 (VSS), U11.16 (VSS), U12.16 (VSS), U13.16 (VSS), U14.16 (GND), U15.3, U15.5, U15.7 (GND), U15.9, U15.11, U15.13, U16.20 (GND), U17.7 (GND), U17.12, U17.13, U18.12 (GND), U19.7 (GND), U20.10 (GND), U21.12 (VSS), U22.12 (GND), U23.8 (GND), U23.22 (GND), U24.2 (VSS), U25.7 (GND), U26.7 (GND), U26.9, U26.10, U28.3 (+), U28.5 (+), U29.5 (GND), U29.6 (GND), U29.7 (GND), U29.8 (GND), U29.9 (GND), U29.12 (GND), U29.14 (GND), U29.19 (GND), U29.30 (GND), U29.41 (GND), U29.51 (GND), U29.63 (GND), U30.7 (GND), U31.7 (GND), U31.12, U31.13, U32.10 (GND), U32.19 (CE), U33.10 (GND), U33.19 (CE), U34.4 (A2), U34.5 (A3), U34.6 (A4), U34.7 (A5), U34.8 (A6), U34.9 (A7), U34.10 (GND), U35.12 (GND), X1.7 (GND), X2.7 (GND)
LEFT: J11.T, R31.1
MP: U24.14 (MP), U27.1, U27.2 (-)
unnamed: C1.1, J15.1, R1.2, RESET1.2, U2.2 (TR), U2.6 (THR)
unnamed: C2.1, U16.32 (X1/CLK), Y1.2
unnamed: C3.1, U16.33 (X2), Y1.1
unnamed: C4.1, U23.9 (XTAL1/PB6), Y2.2
unnamed: C5.1, U23.10 (XTAL2/PB7), Y2.1
unnamed: C6.2, C7.2, L1.1, U24.1 (VDD), U24.3 (VDD)
unnamed: C12.1, R27.2
unnamed: C12.2, U27.13 (-), U27.14
unnamed: C13.1, R28.2
unnamed: C13.2, U27.8, U27.9 (-)
unnamed: C14.1, R27.1, R29.2, U28.2 (-)
unnamed: C14.2, C16.2, R29.1, U28.1
unnamed: C15.1, C17.2, R30.1, U28.7
unnamed: C15.2, R28.1, R30.2, U28.6 (-)
unnamed: C16.1, R31.2
unnamed: C17.1, R32.2
unnamed: COLDRST1.2, J14.1, R25.2, U22.9 (I7)
unnamed: D1.1 (K), R24.2
unnamed: D2.1 (K), R33.2
unnamed: D3.1 (K), J21.1
unnamed: D4.1 (K), R36.2
unnamed: J1.1, U16.29 (OP0)
unnamed: J1.2, U16.12 (OP1)
unnamed: J1.3, U16.28 (OP2)
unnamed: J1.4, U16.13 (OP3)
unnamed: J1.5, U16.27 (OP4)
unnamed: J1.6, U16.14 (OP5)
unnamed: J1.7, R24.1, U16.26 (OP6)
unnamed: J1.8, R33.1, U16.15 (OP7)
unnamed: J2.1, U16.7 (IP0)
unnamed: J2.2, U16.4 (IP1)
unnamed: J2.3, U16.36 (IP2)
unnamed: J2.4, U16.2 (IP3)
unnamed: J2.5, U16.39 (IP4)
unnamed: J2.6, U16.38 (IP5)
unnamed: J3.1, U16.30 (TXDA)
unnamed: J3.2, U16.31 (RXDA)
unnamed: J4.1, U16.11 (TXDB), U23.2 (PD0)
unnamed: J4.2, U16.10 (RXDB), U23.3 (PD1)
unnamed: J10.1 (+3.3V), J10.2 (+3.3V), J10.11 (+3.3V)
unnamed: J12.2, U23.5 (PD3)
unnamed: J12.3, U23.6 (PD4)
unnamed: J13.2, U23.11 (PD5)
unnamed: J13.3, U23.12 (PD6)
unnamed: J16.2, J16.4, J16.6, J16.8, J16.10, U17.5
unnamed: J17.2, J17.4, J17.6, J17.8, J17.10, U26.2
unnamed: J18.2, J18.4, J18.6, J18.8, J18.10, U17.10
unnamed: J19.2, J19.4, J19.6, J19.8, J19.10, U26.13
unnamed: J20.2, J20.4, J20.6, J20.8, J20.10, U26.5
unnamed: J22.1, U25.10
unnamed: R3.2, U1.H2 (HALT)
unnamed: R12.2, U1.H12 (CDIS)
unnamed: R13.2, U1.F13 (MMUDIS)
unnamed: R14.2, U1.C3 (BGACK)
unnamed: R15.2, U1.A1 (BR)
unnamed: R16.2, U1.J1 (CBACK)
unnamed: R17.2, U1.G1 (STERM)
unnamed: R18.2, U16.37 (IACK)
unnamed: R23.2, U24.6 (FSEL)
unnamed: R26.1, U27.6 (-), U27.7
unnamed: R34.2, U29.31 (*DSACK0), U31.4
unnamed: R35.2, U29.32 (*DSACK1), U30.9
unnamed: U1.C1 (FC1), U4.5
unnamed: U1.D1 (FC2), U4.4
unnamed: U2.3 (Q), U15.1
unnamed: U19.1 (A), U19.2 (B), U19.9 (/CLR), U25.2
unnamed: U19.3 (Q0), U25.9
unnamed: U19.4 (Q1), U25.5
unnamed: U19.5 (Q2), U25.3
unnamed: U19.6 (Q3), U25.13
unnamed: U19.13 (Q7), U25.11
unnamed: U21.19 (SMPBD), U24.8 (SMP1)
unnamed: U21.20 (SMPAC), U24.7 (SMP2)
unnamed: U21.21 (DOAB), U24.4 (DIN)
unnamed: U21.23 (SY), U24.5 (CLK)
unnamed: U21.24 (M), X2.8 (OUT)
unnamed: U30.11, U31.1
unnamed: U30.3, U30.12
unnamed: U30.6, U30.13
unnamed: U4.8, U31.2
RIGHT: J11.R, R32.1
R/W: U1.L3 (R/W), U16.8 (R/W), U22.6 (I4), U29.28 (R/*W)
SIZ0: U1.L2 (SIZ0), U22.2 (I0)
SIZ1: U1.K3 (SIZ1), U22.3 (I1)
SWIN: R26.2, U24.12 (SWIN)
/3V3_RD: J9.10, R20.2, U20.1 (A->B), U34.17 (B1)
/3V3_WR: J9.11, R22.2, U34.18 (B0)
/8B: U4.12, U31.3
/8W: J5.23 (~DIOW), PERPORT1.19, U14.31 (PGM), U21.6 (/WR), U22.14 (LR/O4), U34.2 (A0)
/16B: R21.2, U4.1
/32B: U4.2, U4.13, U18.10 (I8), U22.19 (O4/NC)
/AS: J16.1, J17.1, J18.1, J19.1, J20.1, U1.J2 (AS), U25.1, U29.21 (AS), U35.10 (I8)
/ASm: U22.11 (I9), U35.13 (CLK/OD)
/AVEC: U1.E2 (AVEC), U35.22 (O1/A0)
/B0: U6.22 (CE#), U7.22 (CE#), U8.22 (CE#), U9.22 (CE#), U18.23 (O0/LR)
/B1: U10.22 (CE#), U11.22 (CE#), U12.22 (CE#), U13.22 (CE#), U18.22 (O1/A0)
/B2: J6.51, U18.21 (O2/A1)
/B3: J7.51, U18.20 (O3/A2)
/B4: J8.51, U18.19 (O4/NC)
/BERR: J22.2, R19.2, U1.H1 (BERR)
/DS: U1.K2 (DS), U22.1 (OD/CLK), U22.7 (I5), U29.20 (*DS)
/DSACK0: U1.F1 (DSACK0), U31.6
/DSACK1: U1.G2 (DSACK1), U30.8
/DTACK_IO0: U17.3, U30.1
/DTACK_IO1: U17.6, U30.2
/DTACK_IO2: U17.8, U30.4
/DTACK_IO3: U26.11, U30.5
/DTACK_IO4: U4.9, U26.3
/DTACK_ROM: U4.10, U26.6
/INT0: R4.2, U5.11 (I1)
/INT1: R5.2, U5.12 (I2)
/INT2: R6.2, U5.13 (I3)
/INT3: PERPORT1.24, R7.2, U5.1 (I4)
/INT4: R8.2, U5.2 (I5), U21.2 (/IRQ)
/INT5: R9.2, U5.3 (I6), U16.21 (IRQ)
/INT6: R10.2, U5.4 (I7)
/IO: R11.2, U1.L1 (CIIN), U18.11 (I9), U22.16 (A1/O2)
/IO0: U16.35 (CS), U17.1, U18.18 (NC/O0)
/IO1: J5.37 (~CS0), U17.4, U18.17 (A2/O1)
/IO2: PERPORT1.23, U17.9, U18.16 (A1/O2)
/IO3: U18.15 (A0/O3), U21.8 (/CS), U26.12
/IO4: U18.14 (LR/O4), U20.19 (CE), U26.1, U34.19 (CE)
/LLW: J6.43, J7.43, J8.43, U6.29 (WE#), U12.29 (WE#), U22.20 (O3/A2)
/LMW: J6.45, J7.45, J8.45, U7.29 (WE#), U13.29 (WE#), U22.21 (O2/A1)
/MDSACK0: U4.11, U30.10
/MDSACK1: U4.3, U31.5
/R: J5.25 (~DIOR), J6.41, J7.41, J8.41, PERPORT1.20, U6.24 (OE#), U7.24 (OE#), U8.24 (OE#), U9.24 (OE#), U10.24 (OE#), U11.24 (OE#), U12.24 (OE#), U13.24 (OE#), U14.24 (OE), U21.7 (/RD), U22.17 (A2/O1), U34.3 (A1)
/RAMOFF: R36.1, U22.15 (A0/O3)
/ROM: U14.22 (CE), U22.18 (NC/O0), U26.4
/UART_DTACK: U16.9 (DTACK), U17.2
/UMW: J6.47, J7.47, J8.47, U8.29 (WE#), U10.29 (WE#), U22.22 (O1/A0)
/UUW: J6.49, J7.49, J8.49, U9.29 (WE#), U11.29 (WE#), U22.23 (O0/LR)
/WAIT_0: J16.3, J17.3, J18.3, J19.3, J20.3, U25.8
/WAIT_1: J16.5, J17.5, J18.5, J19.5, J20.5, U25.6
/WAIT_2: J16.7, J17.7, J18.7, J19.7, J20.7, U25.4
/WAIT_3: J16.9, J17.9, J18.9, J19.9, J20.9, U25.12
/fpuCS: U29.29 (*CS), U35.23 (O0/LR)
~IPL0: U1.H13 (IPL0), U5.9 (S0)
~IPL1: U1.G13 (IPL1), U5.7 (S1)
~IPL2: U1.G12 (IPL2), U5.6 (S2)
~RST: J5.1 (RESET), PERPORT1.26, R2.2, U1.F12 (RESET), U15.2, U16.34 (RESET), U21.3 (/IC), U23.1 (~RESET/PC6), U29.13 (*RESET)

Notes on the sheet:
WAIT STATE GENERATOR
0x0x2xxxxx
0x0x6xxxxx
WRITE/RD / RAM ROM IO SELECT
0xCx0xxxxx
VIDEO GENERATOR
0xCx8xxxxx
0x0x8xxxxx
0x0x0xxxxx
NO dtack for sound chip!!!
0xCx2xxxxx
0xCxxxxxxx
0x00000000
0x8xxxxxxx
Chip select generator
0xCx4xxxxx
0x0x4xxxxx
0xCx6xxxxx
